Hocus-Pocus/Speeduino-DP1600i-/README.md

# Speeduino-DP1600i-
This is an expanded version of Buggly SPD. It offers the user some options and a proto area if more features than the Buggly SPD board has are desired

WORK IN PROGRESS
