Hocus-Pocus/Speeduino-DP1600i-/KiCad Files/Single VR Conditioner/report.txt

Plot: "C:\Users\angel\Dropbox\My PC (Backup-PC)\Documents\KiCad Projects\Single VR Conditioner\Single VR Conditioner.pdf" OK.

Plot: "C:\Users\angel\Dropbox\My PC (Backup-PC)\Documents\KiCad Projects\Single VR Conditioner\Single VR Conditioner.pdf" OK.
