Hocus-Pocus/Speeduino-DP1600i-/KiCad Files/DP1600iAuxBot/DP1600iAuxBot BOM.xls

DP1600iAuxBot BOM
Designator | Qty | Value | Digikey part
C1 | 1 | 0.01uf | 399-4148-ND (10000pf)
C2 | 1 | 0.1uf | 399-9775-ND
D1,3 | 2 | 1N5818-TP | 1N5818-TCPT-ND
D2,4 | 2 | 1N5231B | 1N5231B-ND
IC1 | 2 | 1x4pin socket | 929850-01-04-ND
J1 | 1 | DB25 board female | 626-2071-ND
J2 | 1 | 1x2 pin socket | 952-1775-ND
J3 | 1 | 1x3 pin socket | A32904-ND
J4 | 1 | 1x6 pin socket | A32907-ND
J5 | 1 | 1x9 pin socket (10) | A26421-ND
J6 | 1 | 1x10 pin socket | A26421-ND
JP1,2 | 2 | 1x2 pin header | 3M9457-36-ND (36 pin)
JP3,4,5,6,7 | 2 | 1x3 pin header
Q1 | 1 | 2N3906-AP | 2N3906-APCT-ND
R1 | 1 | 24K 1/4W 5% | 24KQBK-ND
R2 | 1 | 4.7K 1/4W 5% | 4.7KQBK-ND
R3,14,15 | 3 | 1K 1/4W 5% | 1.0KQBK-ND
