Hocus-Pocus/Speeduino-DP1600i-/KiCad Files/DP1600i/DP1600i BOM.xls

DP1600i BOM
Designator | Qty | Value | Digikey Part
C1,2,5,6,11,13,19,23,26,27,28,29,30 | 13 | 0.1uf | 399-9774-ND
C7,8,14,15,16,24, | 6 | 0.22uf | 399-4288-ND
C9,10 | 2 | 47pf | 399-9737-ND
C17,25 | 2 | 0.01uf | 399-4148-ND (1000pf)
C18 | 1 | 10uf | 399-18278-1-ND
C22 | 1 | 47uf | P19658CT-ND
D1,3,5,7,9,11,13,15,17, | 9 | 1N5818-TP | 1N5818-TPCT-ND
D2,4,6,8,10,12,16,18 | 8 | 1N5321B | 1N5321B-ND
F1 | 1 | MF-R0-50 | MF-R050-ND
J1 | 1 | D25 Board Male | 732-618025231221-ND
J3 | 1 | 1x7 pin header | 609-6393-ND (36 terminals)
J4,J9 | 0 | 1x8 pin header | "
J5 | 0 | 1x4 pin header | "
J6 | 0 | 1x2 pin header | "
J11 | 0 | 1x5 pin header | "
JP1 | 0 | 1x2 pin header | "
J7 | 1 | 2x4 pin header | 3M156309-08-ND
R1 | 1 | 1.5K 1/4W 1% | 1.5KADCT-ND
R2 | 1 | 3.9K 1/4W 1% | 3.9KADCT-ND
R3,4,9,10,11,14 | 6 | 470R 1/4W 5% | 470QBK-ND
R5,6 | 2 | 51K 1/4W 5% | 51KQBK-ND
R7,8 | 2 | 2.49K 1/4W 1% | 2.49KXBK-ND
R12 | 1 | 10K 1/4W 5% | 10KQBK-ND
R13 | 1 | 120R | 120QBK-ND
R15,…R24 | 10 | 22R | CF14JT22ROCT-ND
RV1 | 1 | ERZ-V14P220 | P7307-ND
U1,2 | 2 | MPXH6115 | MPXH6115AC6U
U1,U2 sockets | 2 | 1x4 header sockets | 929850-01-04-ND
U1,U2 pins | 2 | 1x4 90 degree pins | 23-0022122041-ND
U3 | 1 | LM2937ET-5.0 | LM2937ET-5.0-ND
U4,5,6,7,8 | 5 | IXDNI604PI | CLA335-ND
U4,5,6,7,8 sockets | 5 | DIP8 | 110-87-308-41-001101
U10 | 2 | A4988 StepStick sockets | 929850-01-08-10
U9 | 1 | 1ULN2004AN | 296-1980-5-ND
U9 socket | 1 | 110-13-316-41-00100 | ED56163-ND
 | 1 | Hammond 1455N1202 | HM975-ND
