Hocus-Pocus/Speeduino-DP1600i-/KiCad Files/DP1600iAuxTop/DP1600iAuxTop BOM.xls

DP1600iAuxTop BOM
Designator | Qty | Value | Digikey part
D8,,,,D13,D21,…D29,34 | 16 | 1N4001GP-E3/54 | 1N4001GP-E3/54GICT-ND
LED1 | 1 | Orange LED | 1516-1361-ND
LED16,17,18,19 | 4 | Red LED | 1516-1360-ND
LED14,15 | 2 | Yellow LED | 1516-1362-ND
LED30,31,32,33 | 4 | Blue LED | 1516-1365-ND
LED20 | 1 | Yellow/Green LED | 1516-1363-ND
LED2 | 1 | Green LED | 1516-1364-ND
F1,3,…F9 | 6 | Fuse holder | F065-ND
F2 | 1 | RXEF135-1 | RXEF135-1-ND
J1 | 1 | 1x10 pin header | 3M9457-36-ND (36 pin)
J5 | 0 | 1x2 pin header | "
J13 | 0 | 1x6 pin header | "
J20 | 0 | 1x3 pin header | "
J23 | 0 | 1X9 pin header | "
J30 | 1 | 1x2 screw terminal
J31 | 1 | 1x8 screw terminal | (1729076) 277-1242-ND
J32,36 | 2 | 1x3 screw terminal | (1729021) 277-1237-ND
J32,36 | 2 | 1x4 screw terminal | (1729034) 277-1238-ND
J33,35 | 2 | 1x2 screw terminal | (1729018)
J34 | 1 | 1x6 screw terminal | (1729050)
 | 1 | DB25 free male | (DB25-SD-SL) 2057-DB25-D-SL-ND
 | 1 | DB25 free female | (DB25-PD) 2057-DB25-PD-ND
 | 2 | DB25 shell | 116-40-9725H-ND
K1,2 | 2 | 1432786-1 | PB681-ND
K1,2 socket | 2 | Relay socket | VCF4-1000
Q1,2,3,4,5,6 | 6 | AUIRF3205 | AUIRF3205-ND
Q7,8,9,10 | 4 | ISL9V3040P3 | ISL9V3040P3-ND
 | 10 | TO220 insulator | HS417-ND
R7,…R13,R19,…R22 | 13 | 2.4K 1/4W 5% | 2.4KQBK-ND
