Hocus-Pocus/Speeduino-DP1600i-/KiCad Files/VR Conditioner/BOM-octopart-20210223_vr_conditioner_max9926_reg.csv

Qty | Line Item | Manufacturer | MPN | Octopart URL | Schematic Reference | Internal Part Number | Description | Lifecycle Status | Lead Time | RoHS | Total Qty (@ Batch Size: 1) | SKU | SKU | SKU | SKU | Packaging | Packaging | Packaging | Packaging | Unit Price (@ Batch Size: 1) | Unit Price (@ Batch Size: 1) | Unit Price (@ Batch Size: 1) | Unit Price (@ Batch Size: 1) | In Stock | In Stock | In Stock | In Stock | MOQ | MOQ | MOQ | MOQ | URL | URL | URL | URL | Distributor [Lowest Price (Overall)] | SKU [Lowest Price (Overall)] | Packaging [Lowest Price (Overall)] | Unit Price (@ Batch Size: 1) [Lowest Price (Overall)] | Line Total [Lowest Price (Overall)] | Batch Total [Lowest Price (Overall)] | In Stock [Lowest Price (Overall)] | MOQ [Lowest Price (Overall)] | URL [Lowest Price (Overall)] | Notes
 |  |  |  |  |  |  |  |  |  |  |  | Digi-Key | Future Electronics | Mouser | RS Components | Digi-Key | Future Electronics | Mouser | RS Components | Digi-Key | Future Electronics | Mouser | RS Components | Digi-Key | Future Electronics | Mouser | RS Components | Digi-Key | Future Electronics | Mouser | RS Components | Digi-Key | Future Electronics | Mouser | RS Components
1 | GRM1857U1A103JA44D | Murata | GRM1857U1A103JA44D | https://octopart.com/grm1857u1a103ja44d-murata-17754272 |  |  |  | Production (Last Updated: 2 weeks ago) | 23w | Compliant | 1 | 490-8269-1-ND | 1117428 | 81-GRM1857U1A103JA4D |  | Cut Tape | Cut Tape | Tape & Reel |  | 0.15622662 | 0.159777225 | 0.17753025 |  | 24842 | 8000 | 6230 |  | 1 | 1 | 1 |  | https://octopart.com/click/track?country=JE&ct=offers&ppid=17754272&sid=459&sig=0a4da8a&vpid=88253296&ai4=706 | https://octopart.com/click/track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 | https://octopart.com/click/track?country=JE&ct=offers&ppid=17754272&sid=2401&sig=0942290&vpid=37708184&ai4=706 |  | Arrow Electronics | GRM1857U1A103JA44D | Cut Tape | 0.1077253557 | 0.1077253557 | 0.1077253557 | 1 | 1 | https://octopart.com/click/track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
2 | CRCW06031K00FKEAHP | Vishay | CRCW06031K00FKEAHP | https://octopart.com/crcw06031k00fkeahp-vishay-42634138 |  |  |  |  | 24w | Compliant | 2 | 541-1.00KSCT-ND | 7110920 | 71-CRCW06031K00FKEAH | 8206776 | Cut Tape | Cut Tape | Tape & Reel |  | 0.12072057000000001 | 0.104387787 | 0.12072057000000001 |  | 205723 | 16210 | 69615 | 2125 | 1 | 1 | 1 | 25 | https://octopart.com/click/track?country=JE&ct=offers&ppid=42634138&sid=459&sig=04dce86&vpid=115677389&ai4=706 | https://octopart.com/click/track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 | https://octopart.com/click/track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 | https://octopart.com/click/track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 | Farnell | 1738905 | Cut Tape | 0.0412 | 0.0824 | 0.0824 | 32145 | 1 | https://octopart.com/click/track?country=JE&ct=offers&ppid=42634138&sid=819&sig=05fe86e&vpid=250080956&ai4=706
4 | CRCW060310K0FKEAHP | Vishay | CRCW060310K0FKEAHP | https://octopart.com/crcw060310k0fkeahp-vishay-42634028 |  |  |  |  | 24w | Compliant | 4 | 541-10.0KSCT-ND | 6103726 | 71-CRCW060310K0FKEAH | 8206742 | Cut Tape | Cut Tape | Tape & Reel |  | 0.12072057000000001 | 0.104387787 | 0.12072057000000001 |  | 84206 | 65036 | 112208 | 2550 | 1 | 1 | 1 | 25 | https://octopart.com/click/track?country=JE&ct=offers&ppid=42634028&sid=459&sig=0828559&vpid=115262443&ai4=706 | https://octopart.com/click/track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 | https://octopart.com/click/track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 | https://octopart.com/click/track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 | Newark | 68R2991 | Cut Tape | 0.017753025000000002 | 0.07101210000000001 | 0.07101210000000001 | 10760 | 1 | https://octopart.com/click/track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
1 | MAX9926UAEE+ | Maxim Integrated | MAX9926UAEE+ | https://octopart.com/max9926uaee%2B-maxim+integrated-42513566 |  |  |  | Production (Last Updated: 1 month ago) | 6w | Compliant | 1 | MAX9926UAEE+-ND | 3086399 | 700-MAX9926UAEE | 1901381 | Tube | Tube | Tube |  | 4.86432885 |  | 6.44789868 | 4.98 | 1069 | 100 | 299 | 0 | 1 | 100 | 1 | 1 | https://octopart.com/click/track?country=JE&ct=offers&ppid=42513566&sid=459&sig=0fd0a9b&vpid=115650128&ai4=706 | https://octopart.com/click/track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 | https://octopart.com/click/track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 | https://octopart.com/click/track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 | Newark | 73Y6635 |  | 4.73650707 | 4.73650707 | 4.73650707 | 10 | 1 | https://octopart.com/click/track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
1 | GCM188R71C105KA64D | Murata | GCM188R71C105KA64D | https://octopart.com/gcm188r71c105ka64d-murata-13159598 |  |  |  | Production (Last Updated: 2 weeks ago) | 27w | Compliant | 1 | 490-5241-1-ND | 7025260 | 81-GCM188R71C105K64D | 7900562 | Cut Tape | Cut Tape | Tape & Reel |  | 0.15622662 | 0.152676015 | 0.15622662 |  | 272359 | 2118 | 0 | 11400 | 1 | 1 | 1 | 25 | https://octopart.com/click/track?country=JE&ct=offers&ppid=13159598&sid=459&sig=065a155&vpid=34232850&ai4=706 | https://octopart.com/click/track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 | https://octopart.com/click/track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 | https://octopart.com/click/track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 | Arrow Electronics | GCM188R71C105KA64D | Cut Tape | 0.1297391067 | 0.1297391067 | 0.1297391067 | 52386 | 1 | https://octopart.com/click/track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
1 | GRM21BR61E106MA73L | Murata | GRM21BR61E106MA73L | https://octopart.com/grm21br61e106ma73l-murata-46693545 |  |  |  | Production (Last Updated: 2 weeks ago) | 29w | Compliant | 1 | 490-10748-1-ND | 3104124 | 81-GRM21BR61E106MA3L | 1726799 | Cut Tape | Cut Tape | Tape & Reel |  | 0.17753025 | 0.173979645 | 0.18463146 |  | 169134 | 22568 | 63443 | 700 | 1 | 1 | 1 | 50 | https://octopart.com/click/track?country=JE&ct=offers&ppid=46693545&sid=459&sig=0e7381d&vpid=210890997&ai4=706 | https://octopart.com/click/track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 | https://octopart.com/click/track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 | https://octopart.com/click/track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 | Arrow Electronics | GRM21BR61E106MA73L | Cut Tape | 0.1290289857 | 0.1290289857 | 0.1290289857 | 18282 | 1 | https://octopart.com/click/track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
2 | GRM1885C1H102JA01D | Murata | GRM1885C1H102JA01D | https://octopart.com/grm1885c1h102ja01d-murata-196169 |  |  |  | Production (Last Updated: 2 weeks ago) | 29w | Compliant | 2 | 490-1451-1-ND | 5104092 | 81-GRM39C102J50 | 7235795 | Cut Tape | Cut Tape | Tape & Reel |  | 0.07101210000000001 | 0.0102257424 | 0.07101210000000001 |  | 0 | 2890 | 845260 | 5800 | 1 | 1 | 1 | 200 | https://octopart.com/click/track?c=1&country=JE&ct=offers&ppid=196169&sid=459&sig=0c67cea&vpid=1086114&ai4=706 | https://octopart.com/click/track?country=JE&ct=offers&ppid=196169&sid=2454&sig=06c4930&vpid=495870445&ai4=706 | https://octopart.com/click/track?country=JE&ct=offers&ppid=196169&sid=2401&sig=0c58fdf&vpid=37712468&ai4=706 | https://octopart.com/click/track?country=JE&ct=offers&ppid=196169&sid=10022&sig=0888f0c&vpid=199072014&ai4=706 | Future Electronics | 5104092 | Cut Tape | 0.0102257424 | 0.0204514848 | 0.0204514848 | 2890 | 1 | https://octopart.com/click/track?country=JE&ct=offers&ppid=196169&sid=2454&sig=06c4930&vpid=495870445&ai4=706
1 | GCJ188R71C104KA01D | Murata | GCJ188R71C104KA01D | https://octopart.com/gcj188r71c104ka01d-murata-21222040 |  |  |  | Production (Last Updated: 2 weeks ago) | 27w | Compliant | 1 | 490-5796-1-ND | 6113232 | 81-GCJ188R71C104KA1D |  | Cut Tape | Cut Tape | Tape & Reel |  | 0.19173267000000002 | 0.188182065 | 0.17042904 |  | 38484 | 1000 | 178383 |  | 1 | 1 | 1 |  | https://octopart.com/click/track?country=JE&ct=offers&ppid=21222040&sid=459&sig=0e464ea&vpid=44469513&ai4=706 | https://octopart.com/click/track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 | https://octopart.com/click/track?country=JE&ct=offers&ppid=21222040&sid=2401&sig=02bb046&vpid=47654983&ai4=706 |  | Mouser | 81-GCJ188R71C104KA1D | Tape & Reel | 0.17042904 | 0.17042904 | 0.17042904 | 178383 | 1 | https://octopart.com/click/track?country=JE&ct=offers&ppid=21222040&sid=2401&sig=02bb046&vpid=47654983&ai4=706
