Hocus-Pocus/Speeduino-DP1600i-/KiCad Files/DP1600iAuxTop/DP1600iAuxTop.pdf

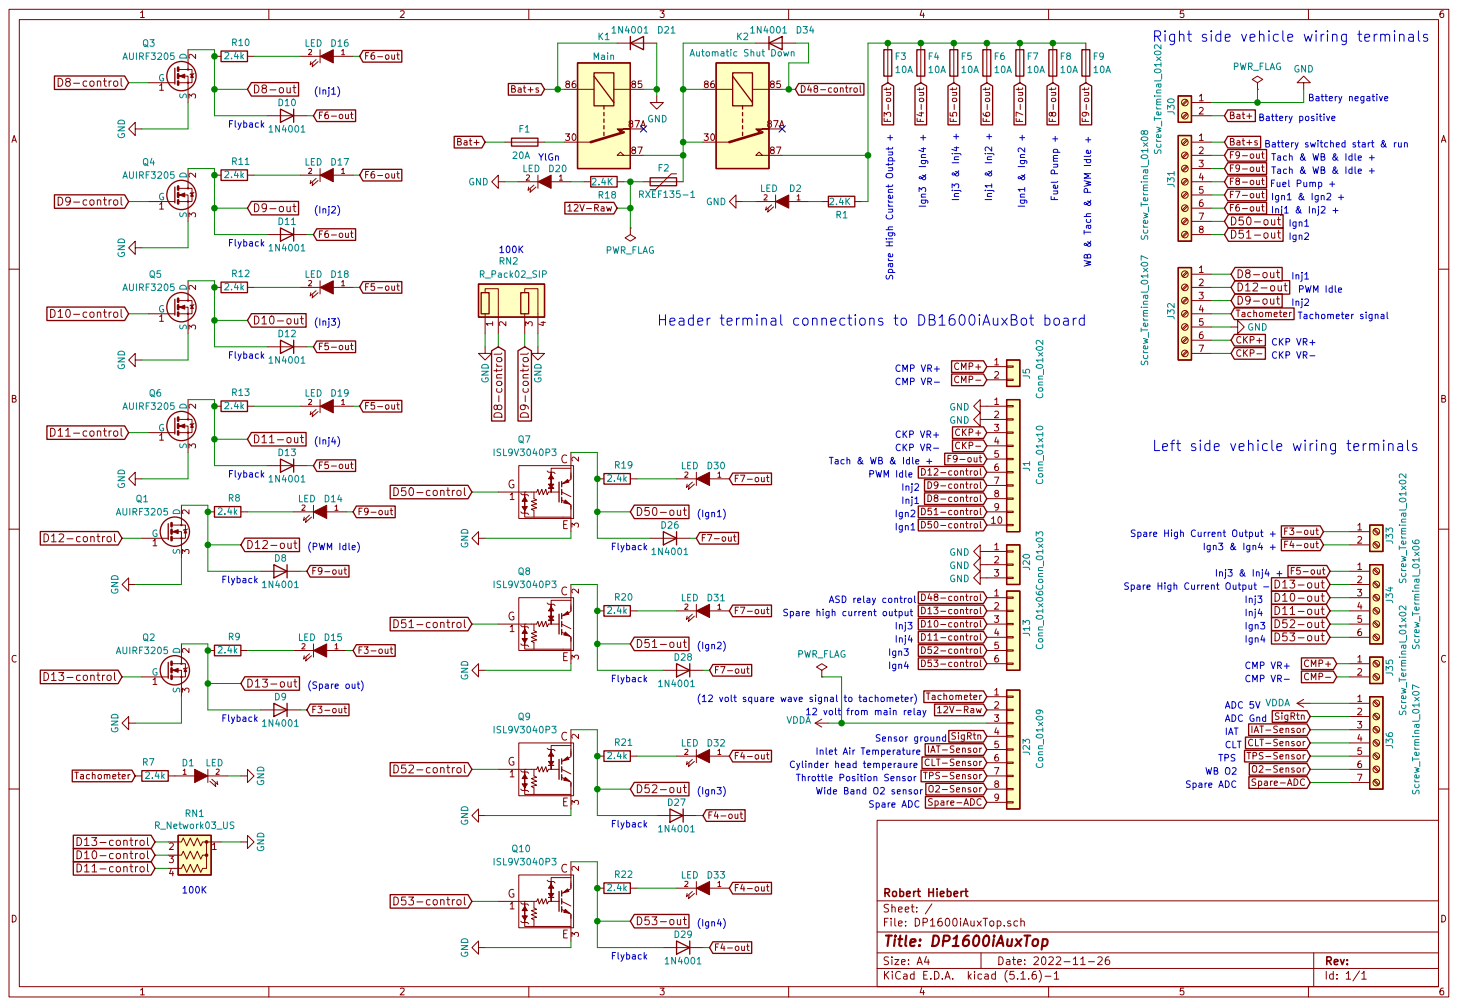
[picture p1: page 1]

Right side vehicle wiring terminals

Battery switched start & run

Header terminal connections to DB1600iAuxBot board

Left side vehicle wiring terminals (Inj4)

Spare-ADC O2-Sensor SigRtnF5-out CLT-Sensor
Inj3 & Inj4 +

Spare High Current Output +

Spare high current output

12 volt from main relay

IAT-Sensor CLT-Sensor O2-Sensor TPS-Sensor Spare-ADC

File: DP1600iAuxTop.sch Sheet: / Robert Hiebert
