Hocus-Pocus/Speeduino-DP1600i-/KiCad Files/DP1600iAuxBot/DP1600iAuxBot.pdf

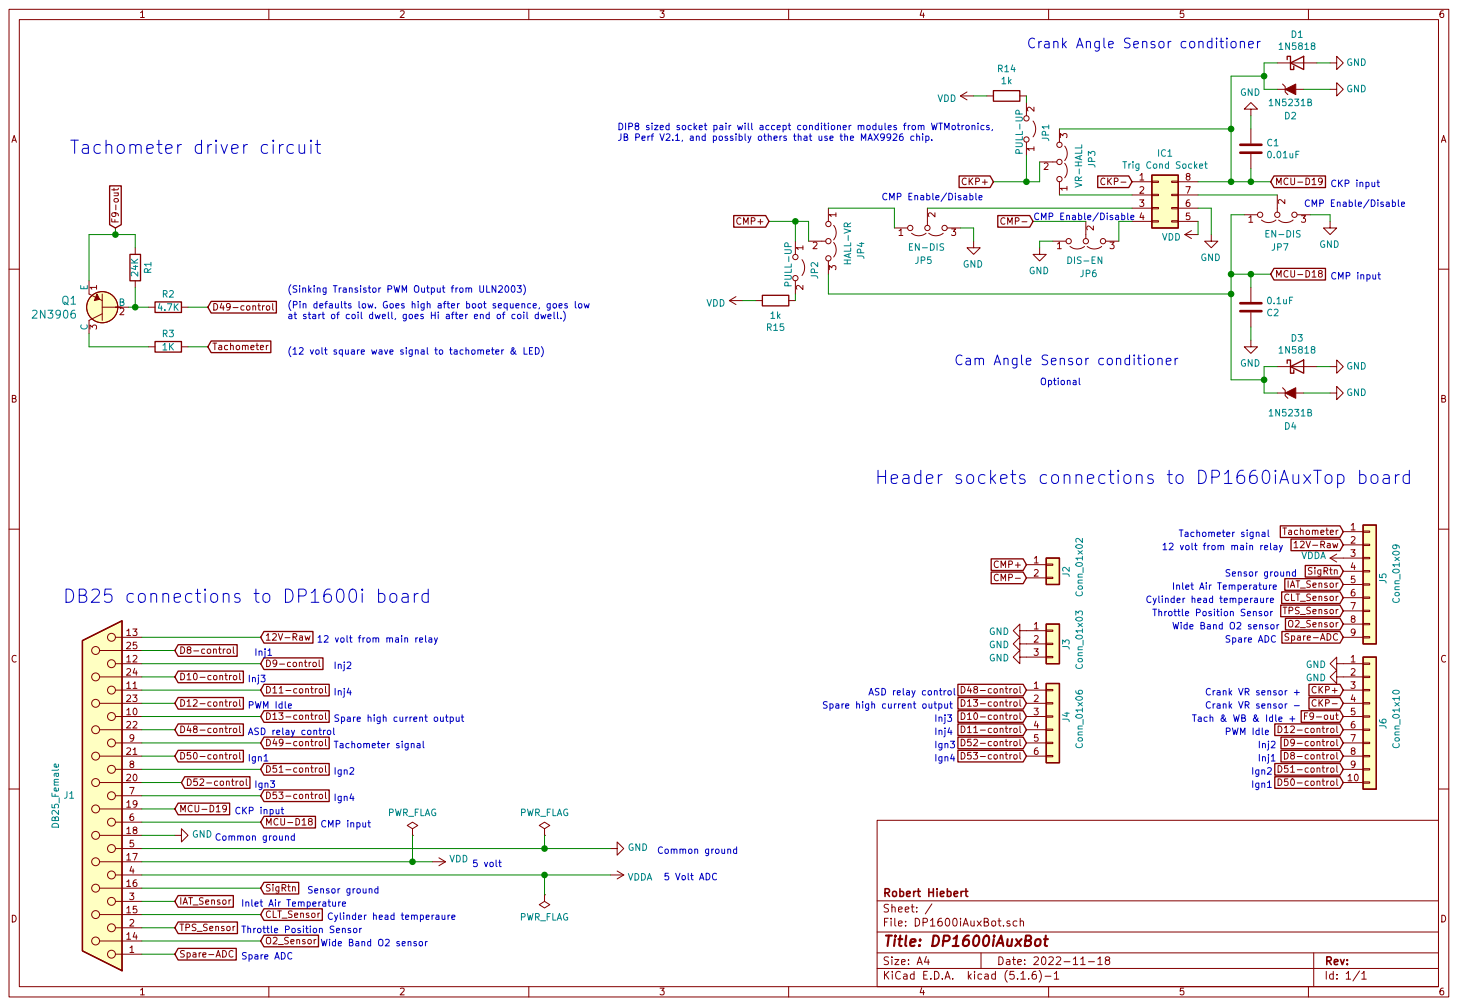
[picture p2: page 1]

Crank Angle Sensor conditioner

DIP8 sized socket pair will accept conditioner modules from WTMotronics,
JB Perf V2.1, and possibly others that use the MAX9926 chip.

(Sinking Transistor PWM Output from ULN2003)
(Pin defaults low. Goes high after boot sequence, goes low

(12 volt square wave signal to tachometer & LED)

Cam Angle Sensor conditioner

Tachometer signal
12 volt from main relay

Id: 1/1 Title: DP1600iAuxBot File: DP1600iAuxBot.sch Sheet: / Robert Hiebert

Inlet Air Temperature
Throttle Position Sensor Wide Band O2 sensor Cylinder head temperaure
