Hocus-Pocus/Speeduino-DP1600i-/KiCad Files/DP1600i/DP1600i.pdf

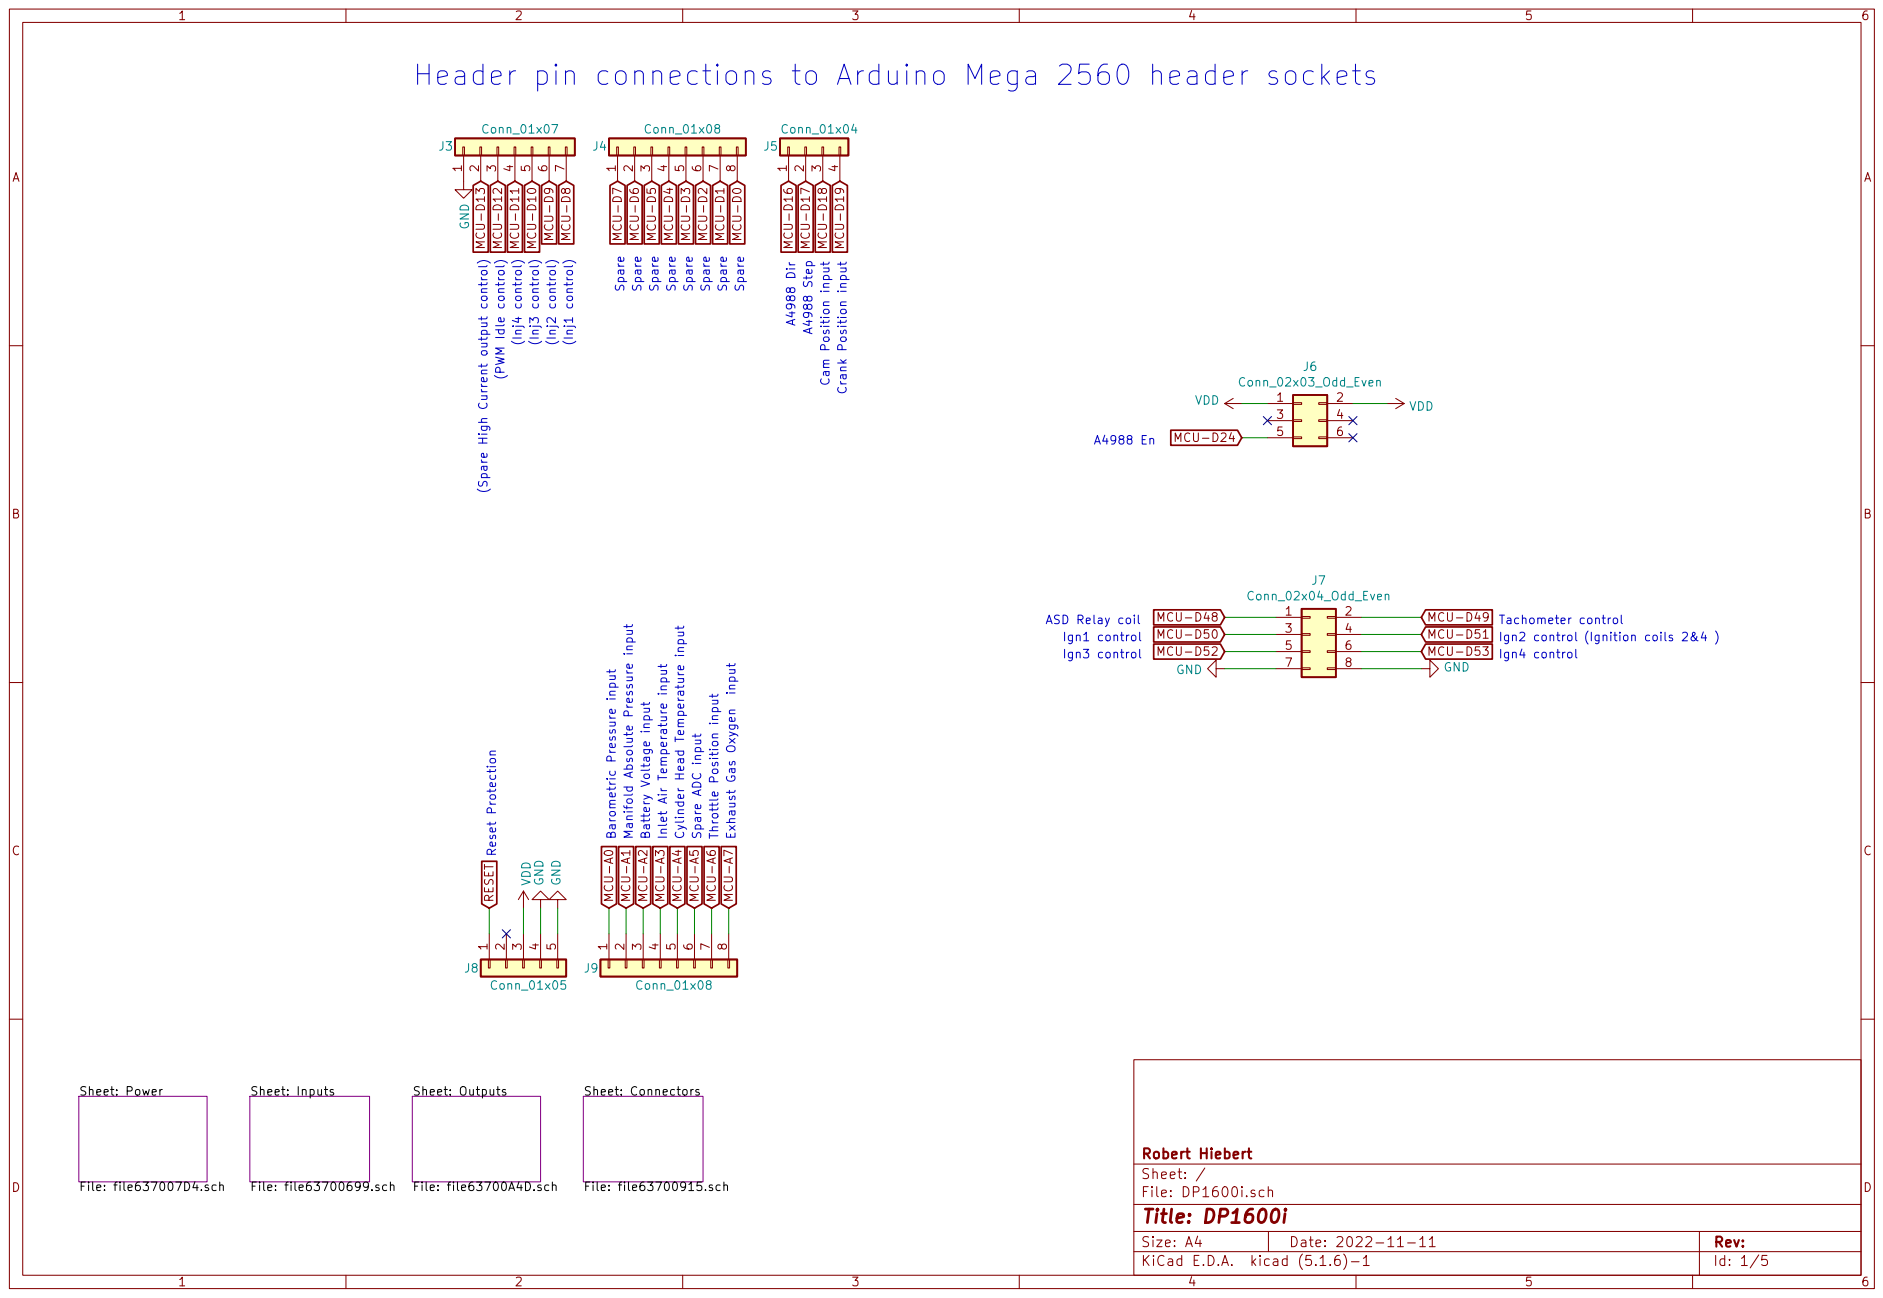
[picture p3: page 1]

VDD VDD GND GND

ASD Relay coil Cam Position input Crank Position input

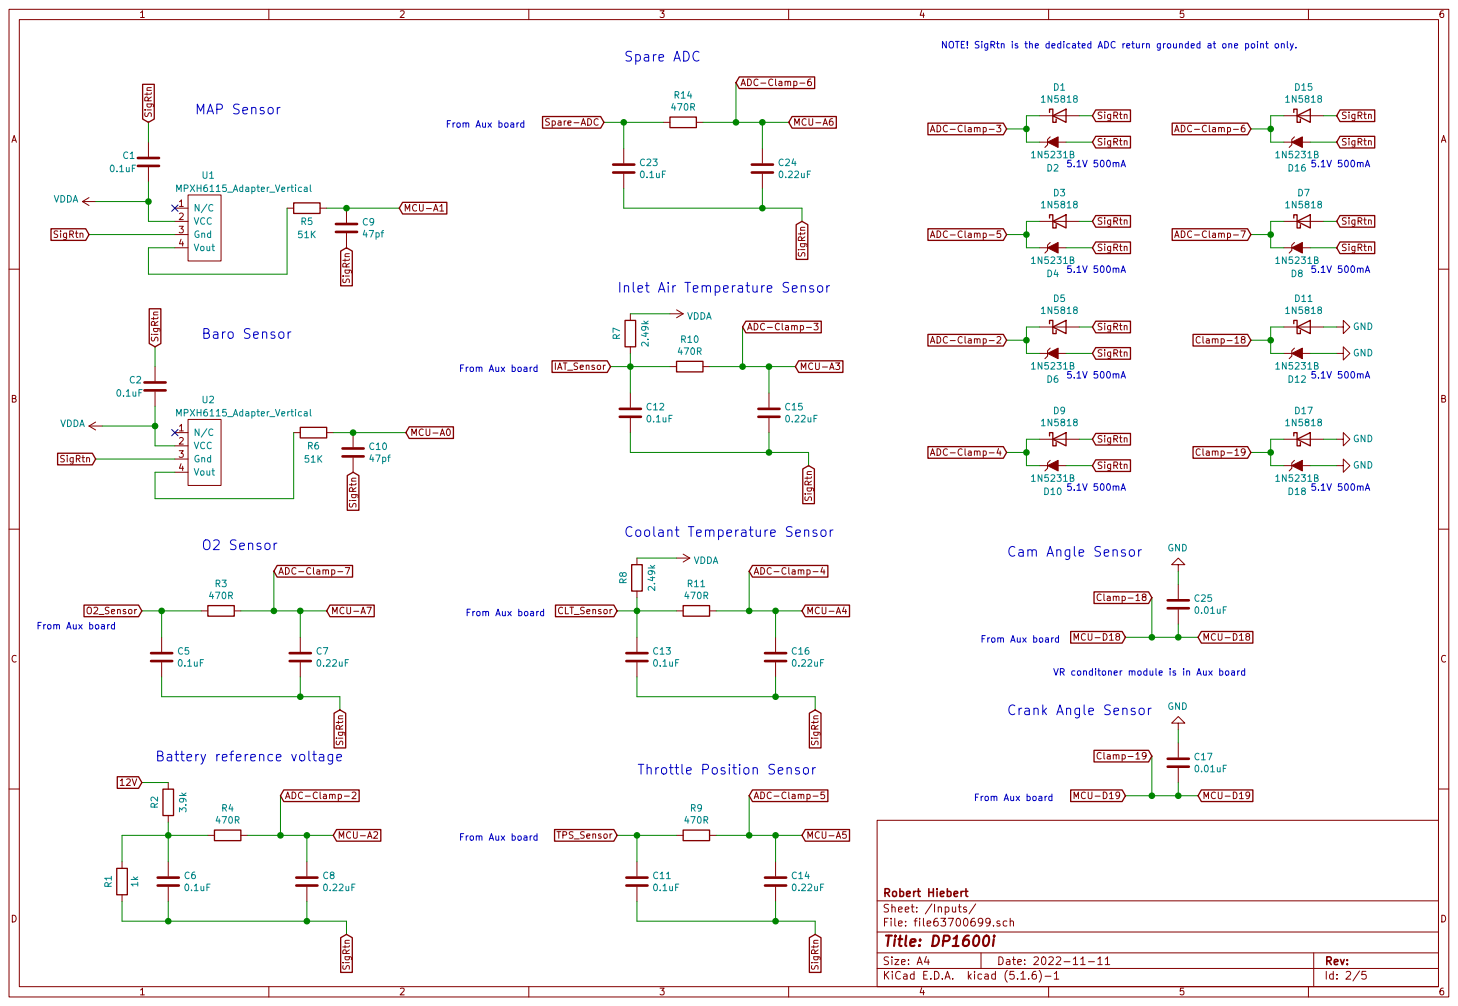
[picture p4: page 2]

From Aux board MAP Sensor

Inlet Air Temperature Sensor

Crank Angle Sensor From Aux board

Id: 2/5 Title: DP1600i File: file63700699.sch Sheet: /Inputs/ Robert Hiebert

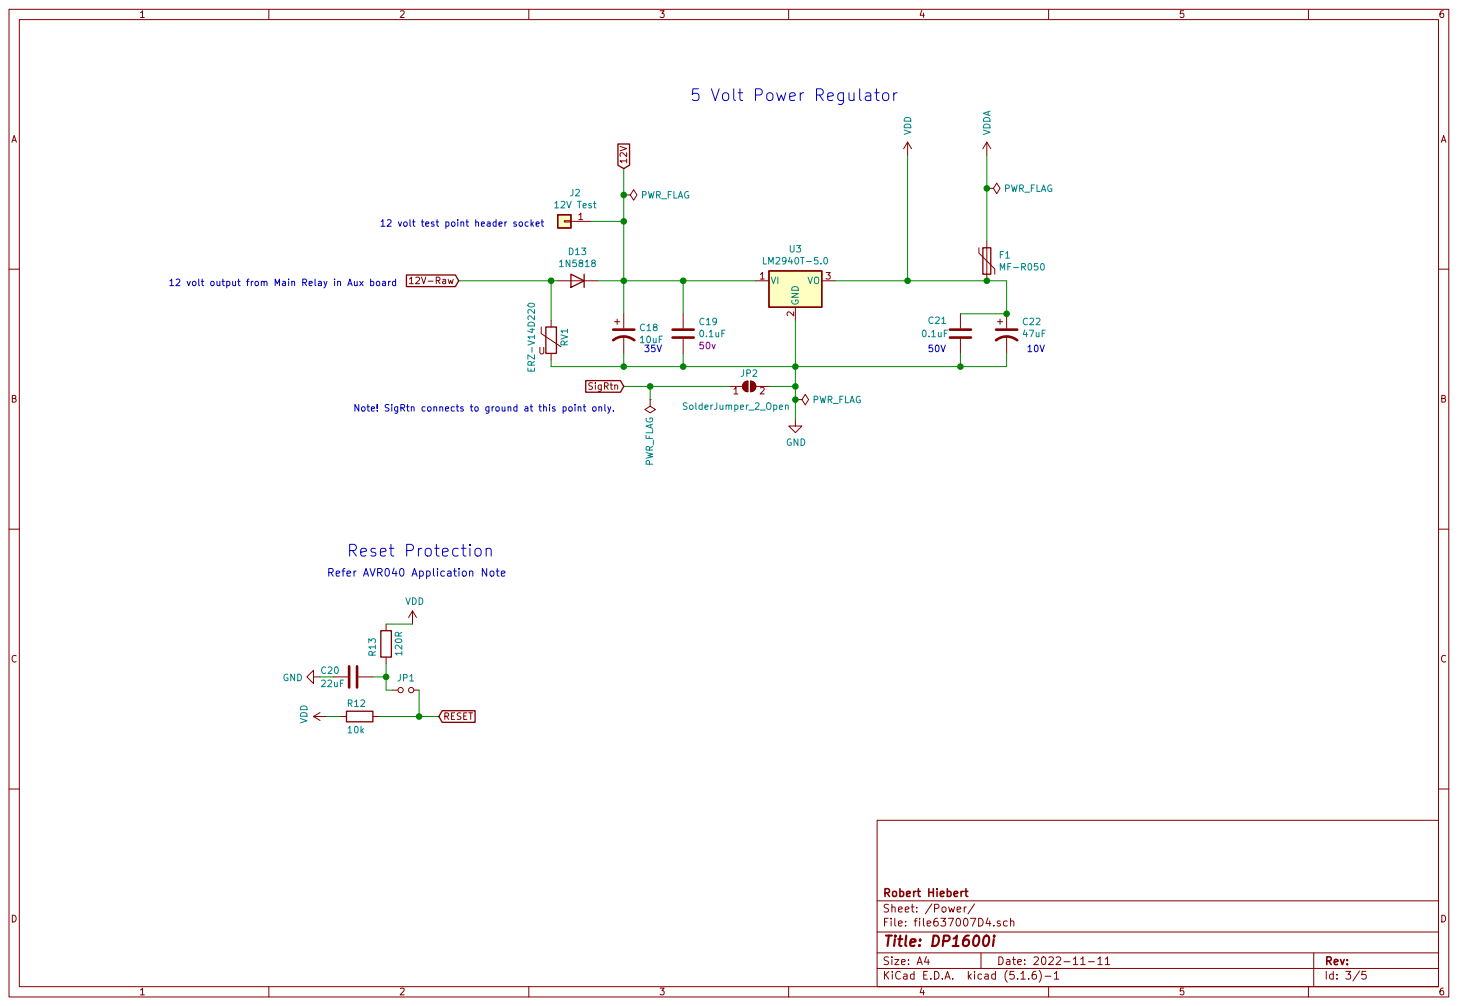
[picture p5: page 3]

Id: 3/5 Title: DP1600i File: file637007D4.sch Sheet: /Power/ Robert Hiebert VDD

12 volt output from Main Relay in Aux board

Note! SigRtn connects to ground at this point only.

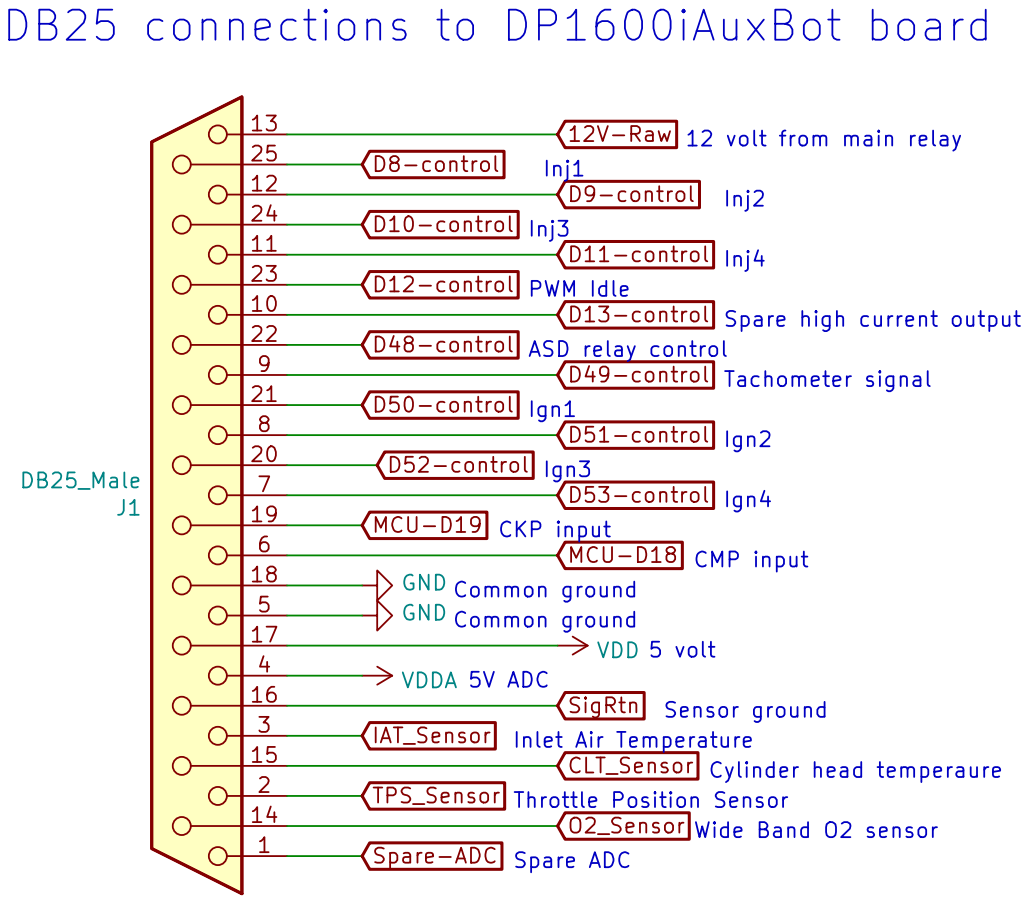
[picture p6: page 4]

5 volt 5V ADC DB25 connections to DP1600iAuxBot board

12 volt from main relay

Spare high current output PWM Idle

Id: 4/5 Title: DP1600i File: file63700915.sch Sheet: /Connectors/ Robert Hiebert VDDA 1

Inlet Air Temperature
CLT_Sensor
Cylinder head temperaure Wide Band O2 sensor Throttle Position Sensor Spare ADC

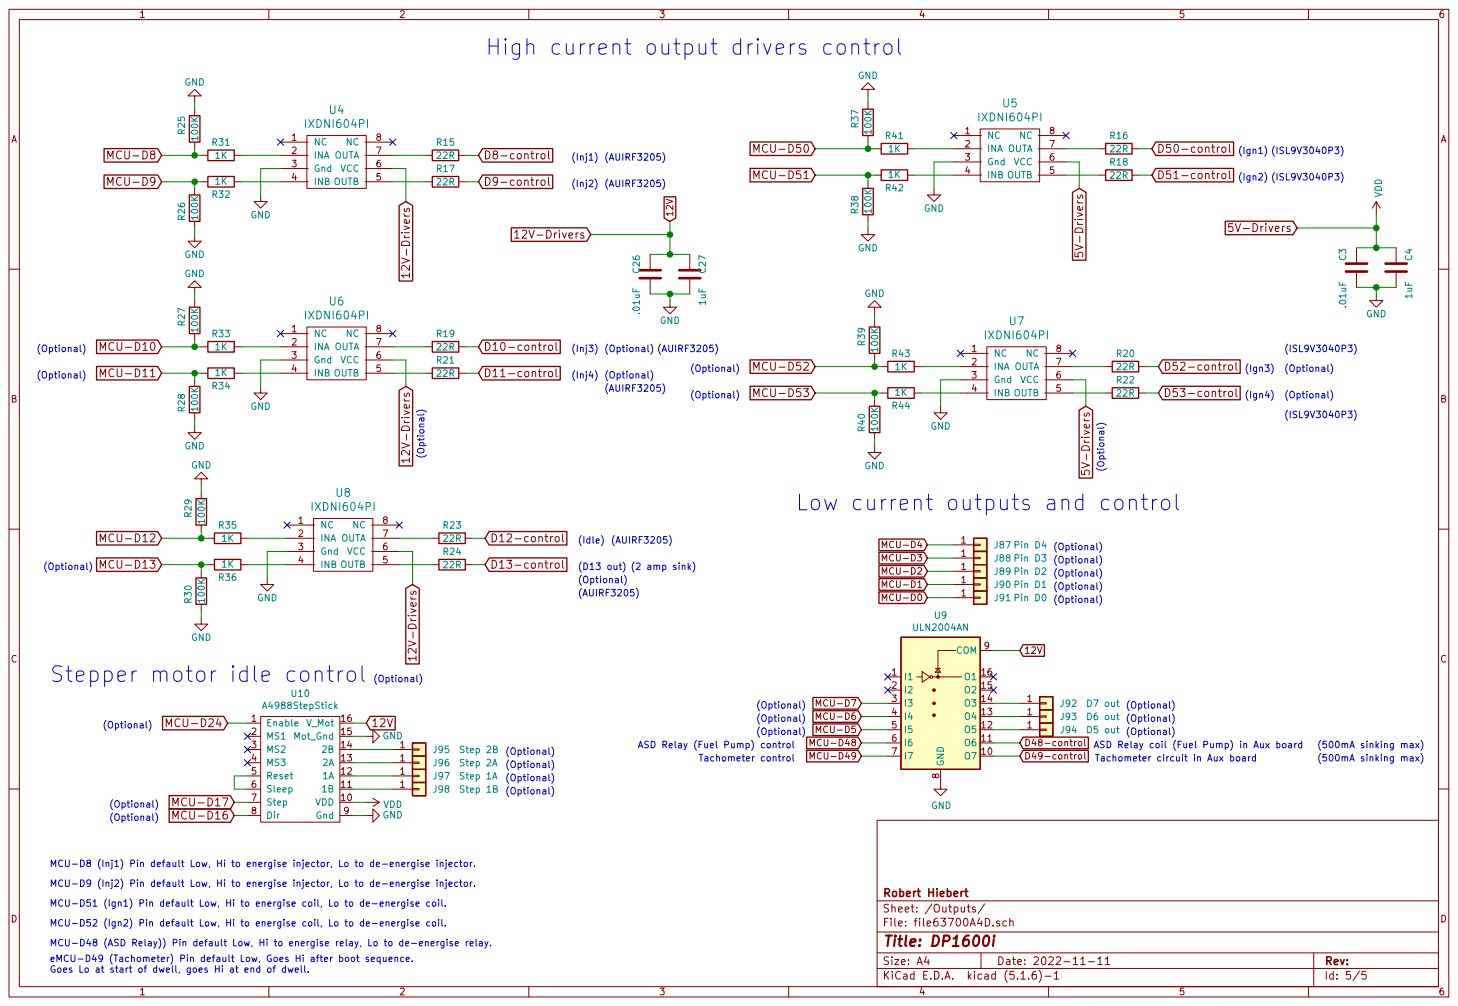
[picture p7: page 5]

High current output drivers control

Low current outputs and control

Stepper motor idle control

MCU-D8 (Inj1) Pin default Low, Hi to energise injector, Lo to de-energise injector.
MCU-D9 (Inj2) Pin default Low, Hi to energise injector, Lo to de-energise injector.
MCU-D51 (Ign1) Pin default Low, Hi to energise coil, Lo to de-energise coil.
MCU-D52 (Ign2) Pin default Low, Hi to energise coil, Lo to de-energise coil.
MCU-D48 (ASD Relay)) Pin default Low, Hi to energise relay, Lo to de-energise relay.
eMCU-D49 (Tachometer) Pin default Low, Goes Hi after boot sequence.
Goes Lo at start of dwell, goes Hi at end of dwell.

Id: 5/5 Title: DP1600i File: file63700A4D.sch Sheet: /Outputs/ Robert Hiebert
