Hocus-Pocus/Speeduino-DP1600i-/KiCad Files/Single VR Conditioner/Single VR Conditioner.pdf

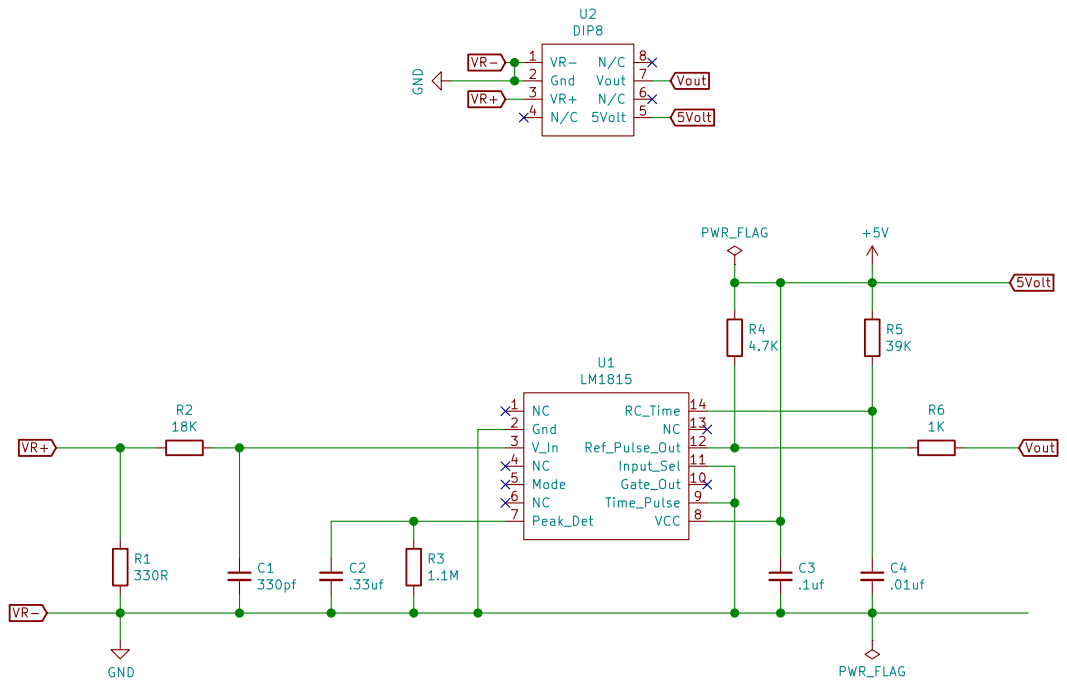
[picture p8: page 1]

File: Single VR Conditioner.sch Sheet: / R. Hiebert Electric C1

Id: 1/1 Title: Buggly Gruesome Single VR Conditioner
