Hocus-Pocus/Speeduino-DP1600i-/KiCad Files/DP1600iAuxBot/DP1600iAuxBot.kicad_pcb

## KiCad design KiCad Files/DP1600iAuxBot/DP1600iAuxBot.kicad_pcb (2022-12-12)

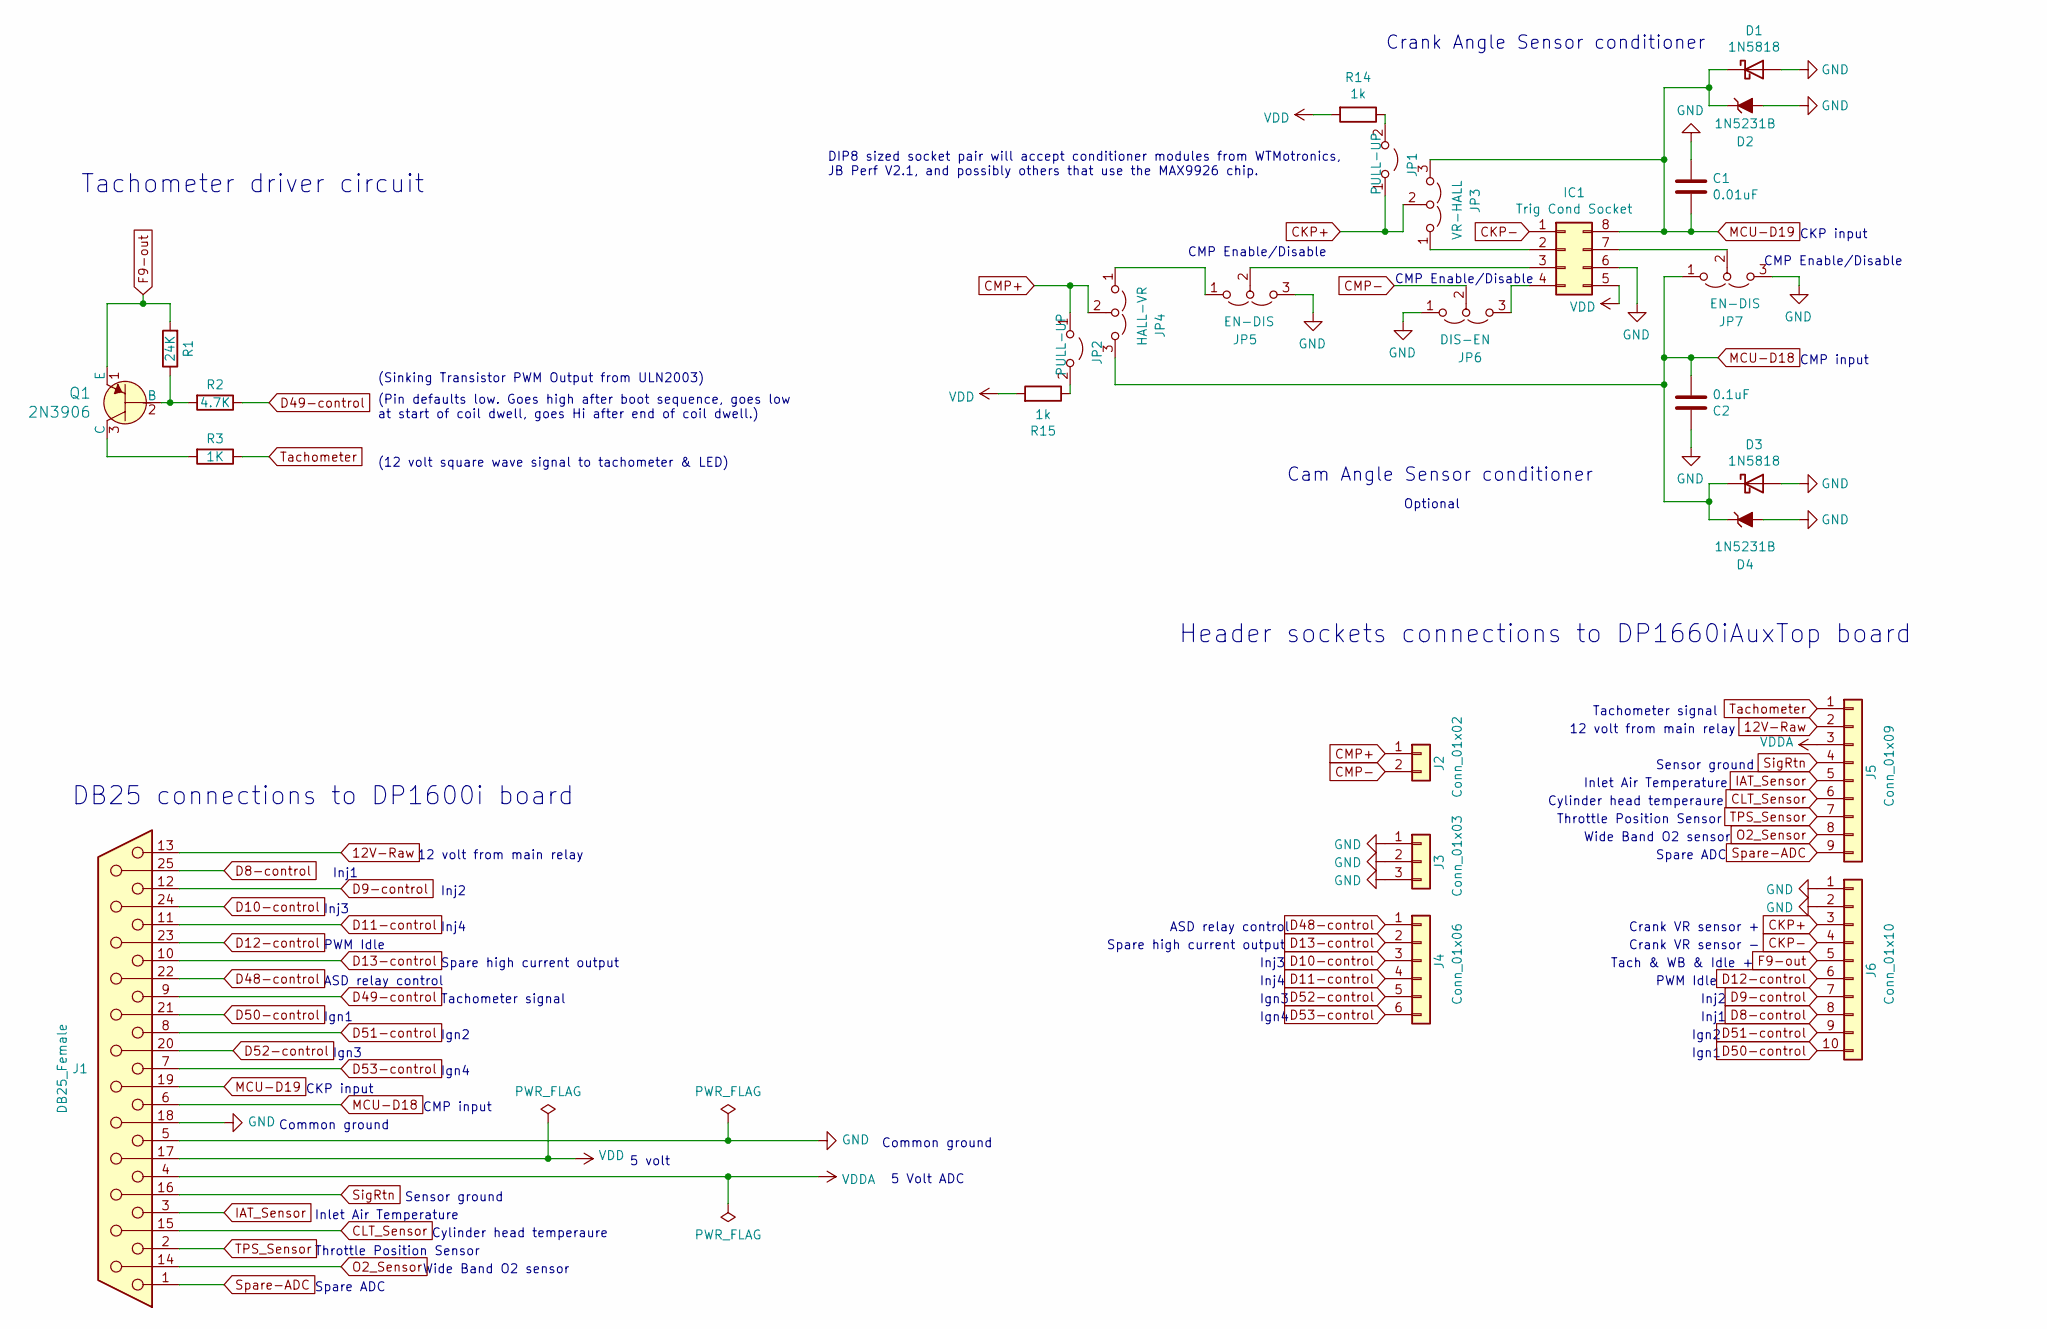
[picture p9: schematic DP1600iAuxBot.sch]

Parts:
C1: 0.01uF; C_Disc_D5.0mm_W2.5mm_P2.50mm; Manufacturer_Part_Number FA18X7R1H103KNU06; Digikey Part Number 445-174244-1-ND
C2: 0.1uF; C_Disc_D5.0mm_W2.5mm_P2.50mm; Manufacturer_Part_Number FA18X8R1E104KNU06; Digikey Part Number 445-180563-1-ND
D1, D3: 1N5818; D_DO-41_SOD81_P10.16mm_Horizontal
D2, D4: 1N5231B; D_DO-41_SOD81_P10.16mm_Horizontal
IC1: Trig Cond Socket; DIP-8_W7.62mm_Socket
J1: DB25_Female; DSUB-25_Female_Horizontal_P2.77x2.84mm_EdgePinOffset4.94mm_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
J2: Conn_01x02; PinHeader_1x02_P2.54mm_Vertical
J3: Conn_01x03; PinHeader_1x03_P2.54mm_Vertical
J4: Conn_01x06; PinHeader_1x06_P2.54mm_Vertical
J5: Conn_01x09; PinHeader_1x09_P2.54mm_Vertical
J6: Conn_01x10; PinHeader_1x10_P2.54mm_Vertical
JP1, JP2: PULL-UP; PinHeader_1x02_P2.54mm_Vertical; Manufacturer_Part_Number M20-9990245; Digikey Part Number 952-2261-ND
JP3: VR-HALL; PinHeader_1x03_P2.54mm_Vertical; Manufacturer_Part_Number M20-9990345; Digikey Part Number 952-2263-ND
JP4: HALL-VR; PinHeader_1x03_P2.54mm_Vertical; Manufacturer_Part_Number M20-9990345; Digikey Part Number 952-2263-ND
JP5, JP7: EN-DIS; PinHeader_1x03_P2.54mm_Vertical; Manufacturer_Part_Number M20-9990345; Digikey Part Number 952-2263-ND
JP6: DIS-EN; PinHeader_1x03_P2.54mm_Vertical; Manufacturer_Part_Number M20-9990345; Digikey Part Number 952-2263-ND
Q1: 2N3906; TO-92_Inline_Wide; MPN 2N3906; Digi-Key_PN 2N3906CS-ND
R1: 24K; R_Axial_DIN0207_L6.3mm_D2.5mm_P7.62mm_Horizontal
R2: 4.7K; R_Axial_DIN0207_L6.3mm_D2.5mm_P7.62mm_Horizontal
R3: 1K; R_Axial_DIN0207_L6.3mm_D2.5mm_P7.62mm_Horizontal
R14, R15: 1k; R_Axial_DIN0207_L6.3mm_D2.5mm_P7.62mm_Horizontal; Manufacturer_Part_Number MBA02040C1001FRP00; Digikey Part Number BC1.00KXCT-ND

Connections:
12V-Raw: J1.13, J5.2
CKP+: J6.3, JP1.1 (A), JP3.2 (C)
CKP-: IC1.1, J6.4
CLT_Sensor: J1.15, J5.6
CMP+: J2.1, JP2.1 (A), JP4.2 (C)
CMP-: J2.2, JP6.2 (C)
D8-control: J1.25, J6.8
D9-control: J1.12, J6.7
D10-control: J1.24, J4.3
D11-control: J1.11, J4.4
D12-control: J1.23, J6.6
D13-control: J1.10, J4.2
D48-control: J1.22, J4.1
D49-control: J1.9, R2.1
D50-control: J1.21, J6.10
D51-control: J1.8, J6.9
D52-control: J1.20, J4.5
D53-control: J1.7, J4.6
F9-out: J6.5, Q1.1 (E), R1.2
GND: C1.1, C2.1, D1.2 (A), D2.2 (A), D3.2 (A), D4.2 (A), IC1.6, J1.5, J1.18, J3.1, J3.2, J3.3, J6.1, J6.2, JP5.3 (B), JP6.1 (A), JP7.3 (B)
IAT_Sensor: J1.3, J5.5
MCU-D18: C2.2, D3.1 (K), D4.1 (K), J1.6, JP4.3 (B), JP7.1 (A)
MCU-D19: C1.2, D1.1 (K), D2.1 (K), IC1.8, J1.19, JP3.3 (B)
unnamed: IC1.2, JP3.1 (A)
unnamed: IC1.3, JP5.2 (C)
unnamed: IC1.4, JP6.3 (B)
unnamed: IC1.7, JP7.2 (C)
unnamed: JP1.2 (B), R14.1
unnamed: JP2.2 (B), R15.1
unnamed: JP4.1 (A), JP5.1 (A)
unnamed: Q1.2 (B), R1.1, R2.2
unnamed: Q1.3 (C), R3.2
O2_Sensor: J1.14, J5.8
SigRtn: J1.16, J5.4
Spare-ADC: J1.1, J5.9
TPS_Sensor: J1.2, J5.7
Tachometer: J5.1, R3.1
VDD: IC1.5, J1.17, R14.2, R15.2
VDDA: J1.4, J5.3

Notes on the sheet:
Crank Angle Sensor conditioner
Cam Angle Sensor conditioner
(Sinking Transistor PWM Output from ULN2003)
(12 volt square wave signal to tachometer & LED)
DB25 connections to DP1600i board
Crank VR sensor +
Crank VR sensor -
12 volt from main relay
Inj1
Inj2
Inj3
Inj4
PWM Idle
Spare high current output
ASD relay control
Tachometer signal
Ign1
Ign2
Ign3
Ign4
CKP input
CMP input
Common ground
5 volt
Sensor ground
Spare ADC
Throttle Position Sensor
Wide Band O2 sensor
Cylinder head temperaure
Inlet Air Temperature
5 Volt ADC
Tach & WB & Idle +
Tachometer driver circuit
Header sockets connections to DP1660iAuxTop board
DIP8 sized socket pair will accept conditioner modules from WTMotronics, JB Perf V2.1, and possibly others that use the MAX9926 chip.
(Pin defaults low. Goes high after boot sequence, goes low at start of coil dwell, goes Hi after end of coil dwell.)
CMP Enable/Disable
Optional

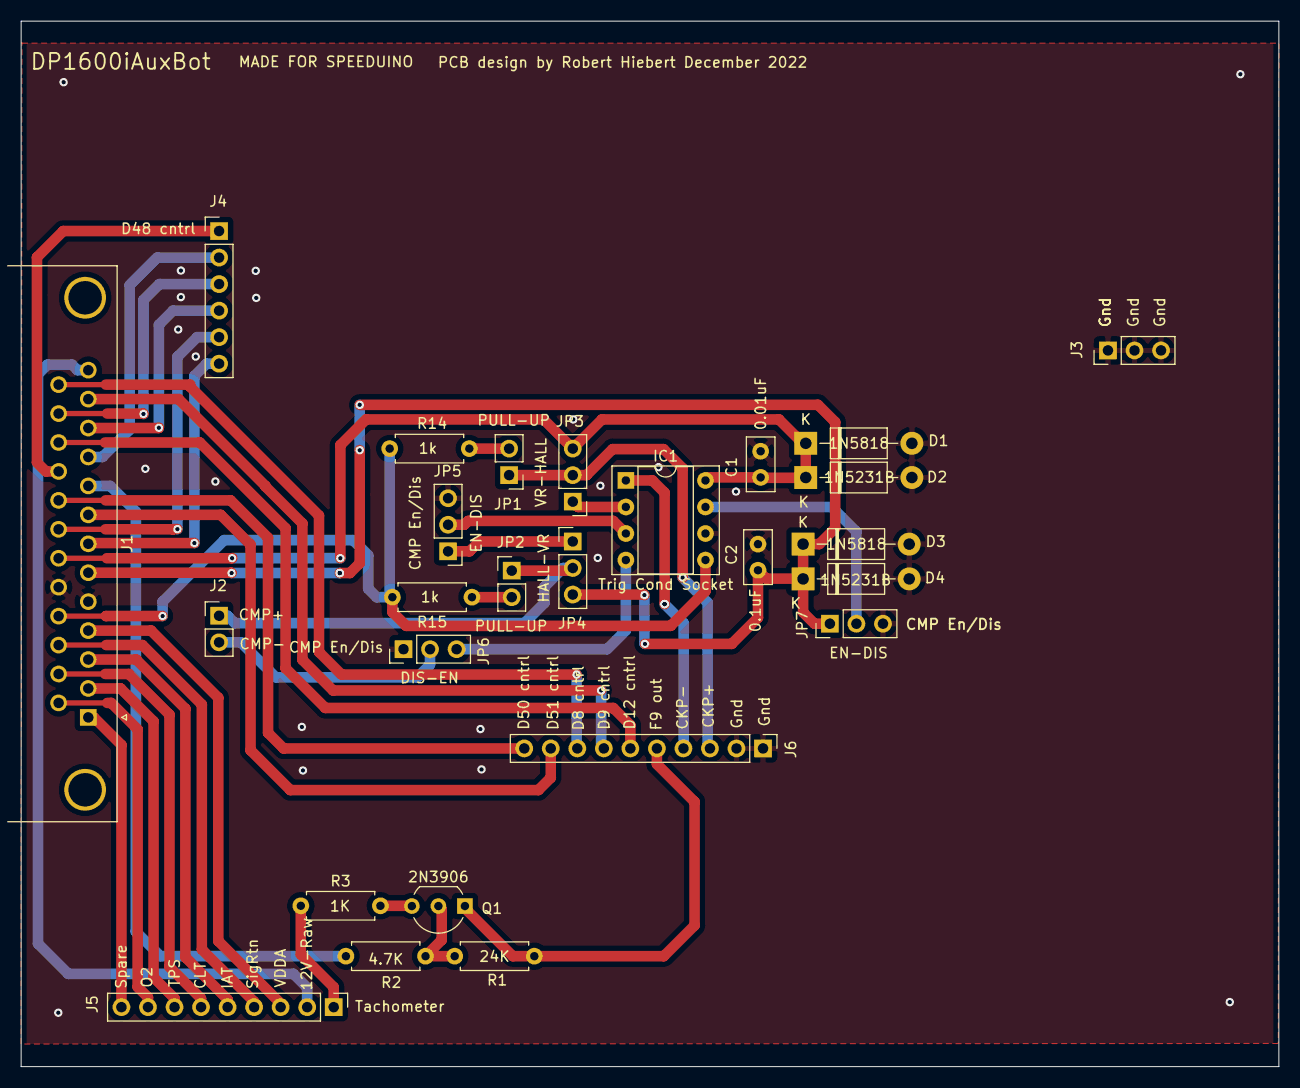
[picture p10: board DP1600iAuxBot.kicad_pcb from above]

Board: 2 copper layers, 120.4 x 100.1 mm, 26 parts (0 on the bottom side), 39 nets.
