Hocus-Pocus/Speeduino-DP1600i-/KiCad Files/DP1600i/DP1600i.kicad_pcb

## KiCad design KiCad Files/DP1600i/DP1600i.kicad_pcb (2022-12-12)

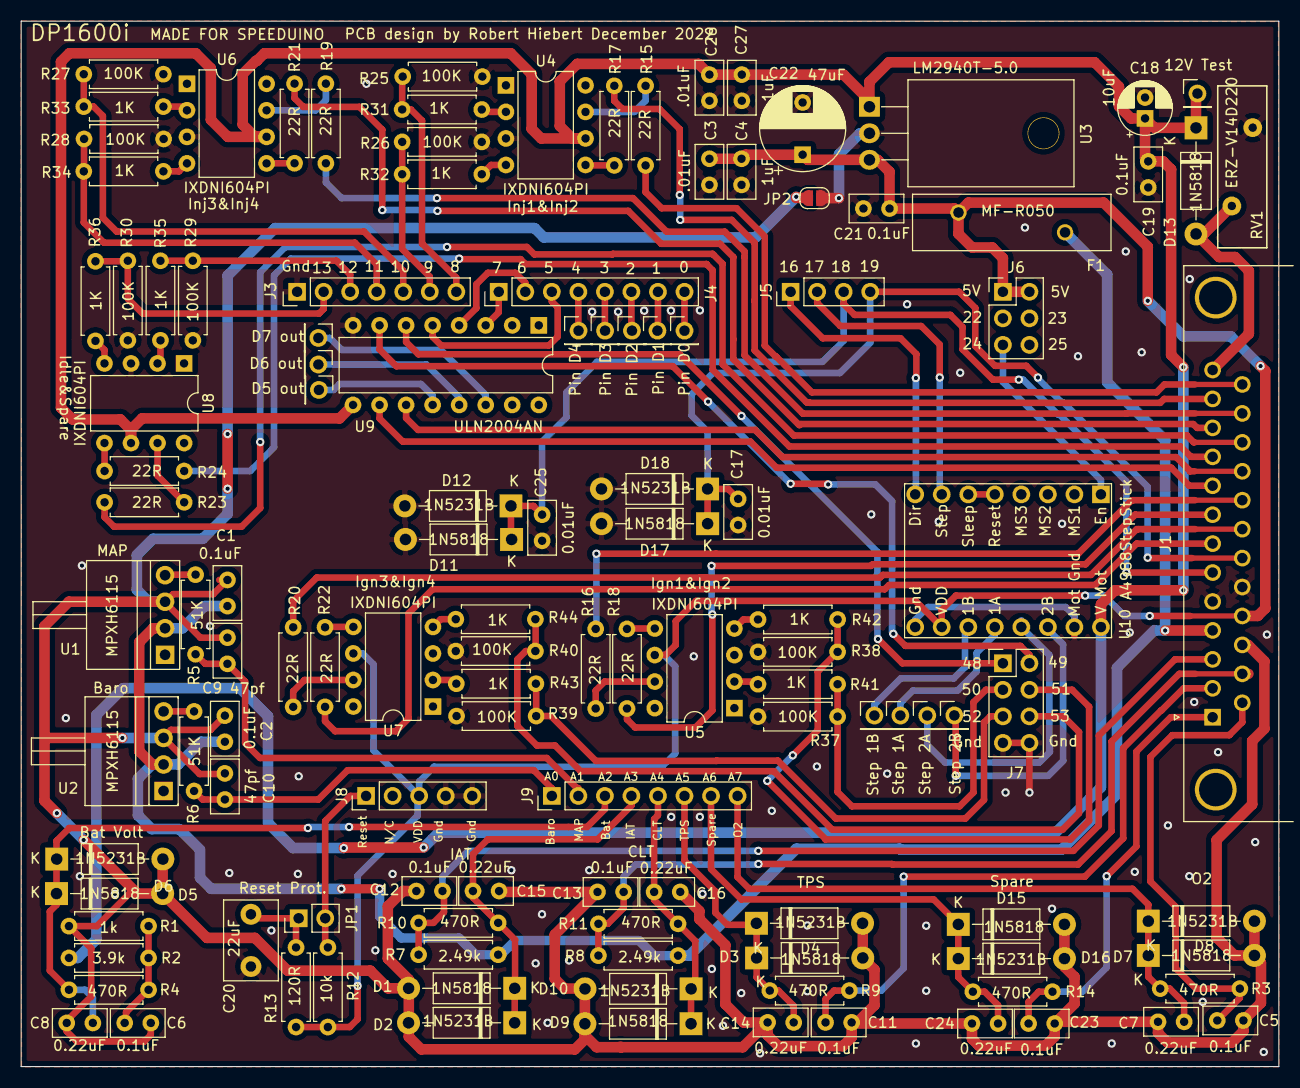
[picture p11: board DP1600i.kicad_pcb from above]

Board: 2 copper layers, 120.4 x 100.1 mm, 123 parts (0 on the bottom side), 89 nets.

Parts:
C1, C2, C5, C6, C11, C12, C13, C19, C21, C23: 0.1uF; C_Disc_D5.0mm_W2.5mm_P2.50mm
C3, C26: .01uF; C_Disc_D5.0mm_W2.5mm_P2.50mm
C4, C27: 1uF; C_Disc_D5.0mm_W2.5mm_P2.50mm
C7, C8, C14, C15, C16, C24: 0.22uF; C_Disc_D5.0mm_W2.5mm_P2.50mm
C9, C10: 47pf; C_Disc_D5.0mm_W2.5mm_P2.50mm
C17, C25: 0.01uF; C_Disc_D5.0mm_W2.5mm_P2.50mm
C18: 10uF; CP_Radial_D5.0mm_P2.00mm
C20: 22uF; C_Disc_D7.5mm_W5.0mm_P5.00mm
C22: 47uF; CP_Radial_D8.0mm_P5.00mm
D1, D3, D5, D7, D9, D11, D13, D15, D17: 1N5818; D_DO-41_SOD81_P10.16mm_Horizontal
D2, D4, D6, D8, D10, D12, D16, D18: 1N5231B; D_DO-41_SOD81_P10.16mm_Horizontal
F1: MF-R050; Fuse_BelFuse_0ZRE0100FF_L18.7mm_W5.1mm
J1: DB25_Male; DSUB-25_Male_Horizontal_P2.77x2.84mm_EdgePinOffset4.94mm_Ho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
J2: 12V Test; Jumper-Pad
J3: Conn_01x07; PinHeader_1x07_P2.54mm_Vertical
J4, J9: Conn_01x08; PinHeader_1x08_P2.54mm_Vertical
J5: Conn_01x04; PinHeader_1x04_P2.54mm_Vertical
J6: Conn_02x03_Odd_Even; PinHeader_2x03_P2.54mm_Vertical
J7: Conn_02x04_Odd_Even; PinHeader_2x04_P2.54mm_Vertical
J8: Conn_01x05; PinHeader_1x05_P2.54mm_Vertical
J87: Pin D4; Jumper-Pad
J88: Pin D3; Jumper-Pad
J89: Pin D2; Jumper-Pad
J90: Pin D1; Jumper-Pad
J91: Pin D0; Jumper-Pad
J92: D7 out; Jumper-Pad
J93: D6 out; Jumper-Pad
J94: D5 out; Jumper-Pad
J95: Step 2B; Jumper-Pad
J96: Step 2A; Jumper-Pad
J97: Step 1A; Jumper-Pad
J98: Step 1B; Jumper-Pad
JP1: Jumper_NO_Small; PinHeader_1x02_P2.54mm_Vertical
JP2: SolderJumper_2_Open; SolderJumper-2_P1.3mm_Open_RoundedPad1.0x1.5mm
R1: 1k; R_Axial_DIN0207_L6.3mm_D2.5mm_P7.62mm_Horizontal
R2: 3.9k; R_Axial_DIN0207_L6.3mm_D2.5mm_P7.62mm_Horizontal
R3, R4, R9, R10, R11, R14: 470R; R_Axial_DIN0207_L6.3mm_D2.5mm_P7.62mm_Horizontal
R5, R6: 51K; R_Axial_DIN0207_L6.3mm_D2.5mm_P7.62mm_Horizontal
R7, R8: 2.49k; R_Axial_DIN0207_L6.3mm_D2.5mm_P7.62mm_Horizontal
R12: 10k; R_Axial_DIN0207_L6.3mm_D2.5mm_P7.62mm_Horizontal
R13: 120R; R_Axial_DIN0207_L6.3mm_D2.5mm_P7.62mm_Horizontal
R15, R16, R17, R18, R19, R20, R21, R22, R23, R24: 22R; R_Axial_DIN0207_L6.3mm_D2.5mm_P7.62mm_Horizontal
R25, R26, R27, R28, R29, R30, R37, R38, R39, R40: 100K; R_Axial_DIN0207_L6.3mm_D2.5mm_P7.62mm_Horizontal
R31, R32, R33, R34, R35, R36, R41, R42, R43, R44: 1K; R_Axial_DIN0207_L6.3mm_D2.5mm_P7.62mm_Horizontal
RV1: ERZ-V14D220; RV_Disc_D15.5mm_W4.7mm_P7.5mm
U1, U2: MPXH6115_Adapter_Vertical
U3: LM2940T-5.0; TO-220-3_Horizontal_TabDown
U4, U5, U6, U7, U8: IXDNI604PI; DIP-8_W7.62mm
U9: ULN2004AN; DIP-16_W7.62mm
U10: A4988StepStick

Connections:
5V-Drivers: C3.2, C4.2, C21.1, C22.1, F1.2, J1.17, J6.1, J6.2, J8.3, R12.2, R13.2, U3.3, U5.6, U7.6, U10.10
12V: C18.1, C19.1, C26.2, C27.2, D13.1, J2.1, R2.2, U3.1, U4.6, U6.6, U8.6, U9.9, U10.16
12V-Raw: D13.2, J1.13, RV1.1
ADC-Clamp-2: C8.1, D5.1, D6.1, J9.3, R4.1
ADC-Clamp-3: C15.1, D1.1, D2.1, J9.4, R10.1
ADC-Clamp-4: C16.1, D9.1, D10.1, J9.5, R11.1
ADC-Clamp-5: C14.1, D3.1, D4.1, J9.6, R9.1
ADC-Clamp-6: C24.1, D15.1, D16.1, J9.7, R14.1
ADC-Clamp-7: C7.1, D7.1, D8.1, J9.8, R3.1
CLT_Sensor: C13.1, J1.15, R8.1, R11.2
Clamp-18: C25.2, D11.1, D12.1, J1.6, J5.3
Clamp-19: C17.2, D17.1, D18.1, J1.19, J5.4
D8-control: J1.25, R15.1
D9-control: J1.12, R17.1
D10-control: J1.24, R19.1
D11-control: J1.11, R21.1
D12-control: J1.23, R23.1
D13-control: J1.10, R24.1
D48-control: J1.22, U9.11
D49-control: J1.9, U9.10
D50-control: J1.21, R16.1
D51-control: J1.8, R18.1
D52-control: J1.20, R20.1
D53-control: J1.7, R22.1
GND: C3.1, C4.1, C17.1, C18.2, C19.2, C20.2, C21.2, C22.2, C25.1, C26.1, C27.1, D11.2, D12.2, D17.2, D18.2, J1.5, J1.18, J3.1, J7.7, J7.8, J8.4, J8.5, JP2.2, R25.1, R26.1, R27.1, R28.1, R29.1, R30.1, R37.1, R38.1, R39.1, R40.1, RV1.2, U3.2, U4.3, U5.3, U6.3, U7.3, U8.3, U9.8, U10.9, U10.15
IAT_Sensor: C12.1, J1.3, R7.1, R10.2
MCU-A0: C10.1, J9.1, R6.1
MCU-A1: C9.1, J9.2, R5.1
MCU-D0: J4.8, J91.1
MCU-D1: J4.7, J90.1
MCU-D2: J4.6, J89.1
MCU-D3: J4.5, J88.1
MCU-D4: J4.4, J87.1
MCU-D5: J4.3, U9.5
MCU-D6: J4.2, U9.4
MCU-D7: J4.1, U9.3
MCU-D8: J3.7, R25.2, R31.2
MCU-D9: J3.6, R26.2, R32.2
MCU-D10: J3.5, R27.2, R33.2
MCU-D11: J3.4, R28.2, R34.2
MCU-D12: J3.3, R29.2, R35.2
MCU-D13: J3.2, R30.2, R36.2
MCU-D16: J5.1, U10.8
MCU-D17: J5.2, U10.7
MCU-D24: J6.5, U10.1
MCU-D48: J7.1, U9.6
MCU-D49: J7.2, U9.7
MCU-D50: J7.3, R37.2, R41.2
MCU-D51: J7.4, R38.2, R42.2
MCU-D52: J7.5, R39.2, R43.2
MCU-D53: J7.6, R40.2, R44.2
unnamed: C6.1, R1.2, R2.1, R4.2
unnamed: C20.1, JP1.1, R13.1
unnamed: J92.1, U9.14
unnamed: J93.1, U9.13
unnamed: J94.1, U9.12
unnamed: J95.1, U10.14
unnamed: J96.1, U10.13
unnamed: J97.1, U10.12
unnamed: J98.1, U10.11
unnamed: R5.2, U1.4
unnamed: R6.2, U2.4
unnamed: R15.2, U4.7
unnamed: R16.2, U5.7
unnamed: R17.2, U4.5
unnamed: R18.2, U5.5
unnamed: R19.2, U6.7
unnamed: R20.2, U7.7
unnamed: R21.2, U6.5
unnamed: R22.2, U7.5
unnamed: R23.2, U8.7
unnamed: R24.2, U8.5
unnamed: R31.1, U4.2
unnamed: R32.1, U4.4
unnamed: R33.1, U6.2
unnamed: R34.1, U6.4
unnamed: R35.1, U8.2
unnamed: R36.1, U8.4
unnamed: R41.1, U5.2
unnamed: R42.1, U5.4
unnamed: R43.1, U7.2
unnamed: R44.1, U7.4
unnamed: U10.5, U10.6
O2_Sensor: C5.1, J1.14, R3.2
RESET: J8.1, JP1.2, R12.1
SigRtn: C1.1, C2.1, C5.2, C6.2, C7.2, C8.2, C9.2, C10.2, C11.2, C12.2, C13.2, C14.2, C15.2, C16.2, C23.2, C24.2, D1.2, D2.2, D3.2, D4.2, D5.2, D6.2, D7.2, D8.2, D9.2, D10.2, D15.2, D16.2, J1.16, JP2.1, R1.1, U1.3, U2.3
Spare-ADC: C23.1, J1.1, R14.2
TPS_Sensor: C11.1, J1.2, R9.2
VDDA: C1.2, C2.2, F1.1, J1.4, R7.2, R8.2, U1.2, U2.2
