Hocus-Pocus/Speeduino-DP1600i-/KiCad Files/DP1600iAuxTop/DP1600iAuxTop.kicad_pcb

## KiCad design KiCad Files/DP1600iAuxTop/DP1600iAuxTop.kicad_pcb (2022-12-04)

Schematic: DP1600iAuxTop.sch

Parts:
D1, D2, D14, D15, D16, D17, D18, D19, D20, D30, D31, D32, D33: LED; LED_D5.0mm
D8, D9, D10, D11, D12, D13, D21, D26, D27, D28, D29, D34: 1N4001; D_DO-41_SOD81_P10.16mm_Horizontal
F1: 20A; 01530008Z_Fuse_Holder
F2: RXEF135-1; Fuse_Bourns_MF-RHT750
F3, F4, F5, F6, F7, F8, F9: 10A; 01530008Z_Fuse_Holder
J1: Conn_01x10; PinHeader_1x10_P2.54mm_Vertical
J5: Conn_01x02; PinHeader_1x02_P2.54mm_Vertical
J13: Conn_01x06; PinHeader_1x06_P2.54mm_Vertical
J20: Conn_01x03; PinHeader_1x03_P2.54mm_Vertical
J23: Conn_01x09; PinHeader_1x09_P2.54mm_Vertical
J30: Screw_Terminal_01x02; Phoenix_1714955
J31: Screw_Terminal_01x08; Phoenix_1729076_Rt
J32: Screw_Terminal_01x07; Phoenix_1729063_Rt
J33, J35: Screw_Terminal_01x02; Phoenix_1730010
J34: Screw_Terminal_01x06; Phoenix_1715190
J36: Screw_Terminal_01x07; Phoenix_1729063
K1: Main; VCF4-1000
K2: Automatic Shut Down; VCF4-1000
Q1, Q2, Q3, Q4, Q5, Q6: AUIRF3205; TO-220-3_Vertical_Wide
Q7, Q8, Q9, Q10: ISL9V3040P3; TO-220-3_Vertical_Wide
R1: 2.4K; R_Axial_DIN0207_L6.3mm_D2.5mm_P2.54mm_Vertical
R7, R8, R9, R10, R11, R12, R13, R19, R20, R21, R22: 2.4k; R_Axial_DIN0207_L6.3mm_D2.5mm_P10.16mm_Horizontal
R18: 2.4K; R_Axial_DIN0207_L6.3mm_D2.5mm_P10.16mm_Horizontal
RN1: R_Network03_US; R_Array_SIP4
RN2: R_Pack02_SIP; R_Array_SIP4

Connections:
12V-Raw: F2.1, J23.2, R18.1
Bat+: F1.2, J30.2
Bat+s: D21.1 (K), J31.1, K1.86
CKP+: J1.3, J32.6
CKP-: J1.4, J32.7
CLT-Sensor: J23.6, J36.4
CMP+: J5.1, J35.1
CMP-: J5.2, J35.2
D8-control: J1.8, Q3.1 (G), RN2.2 (R1.2)
D8-out: D10.1 (A), J32.1, Q3.2 (D), R10.1
D9-control: J1.7, Q4.1 (G), RN2.3 (R2.1)
D9-out: D11.1 (A), J32.3, Q4.2 (D), R11.1
D10-control: J13.3, Q5.1 (G), RN1.3 (R2)
D10-out: D12.1 (A), J34.3, Q5.2 (D), R12.1
D11-control: J13.4, Q6.1 (G), RN1.4 (R3)
D11-out: D13.1 (A), J34.4, Q6.2 (D), R13.1
D12-control: J1.6, Q1.1 (G)
D12-out: D8.1 (A), J32.2, Q1.2 (D), R8.1
D13-control: J13.2, Q2.1 (G), RN1.2 (R1)
D13-out: D9.1 (A), J34.2, Q2.2 (D), R9.1
D48-control: D34.2 (A), J13.1, K2.85
D50-control: J1.10, Q7.1 (G)
D50-out: D26.1 (A), J31.7, Q7.2 (C), R19.1
D51-control: J1.9, Q8.1 (G)
D51-out: D28.1 (A), J31.8, Q8.2 (C), R20.1
D52-control: J13.5, Q9.1 (G)
D52-out: D27.1 (A), J34.5, Q9.2 (C), R21.1
D53-control: J13.6, Q10.1 (G)
D53-out: D29.1 (A), J34.6, Q10.2 (C), R22.1
F3-out: D9.2 (K), D15.1 (A), F3.2, J33.1
F4-out: D27.2 (K), D29.2 (K), D32.1 (A), D33.1 (A), F4.2, J33.2
F5-out: D12.2 (K), D13.2 (K), D18.1 (A), D19.1 (A), F5.2, J34.1
F6-out: D10.2 (K), D11.2 (K), D16.1 (A), D17.1 (A), F6.2, J31.6
F7-out: D26.2 (K), D28.2 (K), D30.1 (A), D31.1 (A), F7.2, J31.5
F8-out: F8.2, J31.4
F9-out: D8.2 (K), D14.1 (A), F9.2, J1.5, J31.2, J31.3
GND: D1.2 (K), D2.2 (K), D20.2 (K), D21.2 (A), J1.1, J1.2, J20.1, J20.2, J20.3, J30.1, J32.5, K1.85, Q1.3 (S), Q2.3 (S), Q3.3 (S), Q4.3 (S), Q5.3 (S), Q6.3 (S), Q7.3 (E), Q8.3 (E), Q9.3 (E), Q10.3 (E), RN1.1 (common), RN2.1 (R1.1), RN2.4 (R2.2)
IAT-Sensor: J23.5, J36.3
unnamed: D1.1 (A), R7.1
unnamed: D2.1 (A), R1.2
unnamed: D14.2 (K), R8.2
unnamed: D15.2 (K), R9.2
unnamed: D16.2 (K), R10.2
unnamed: D17.2 (K), R11.2
unnamed: D18.2 (K), R12.2
unnamed: D19.2 (K), R13.2
unnamed: D20.1 (A), R18.2
unnamed: D30.2 (K), R19.2
unnamed: D31.2 (K), R20.2
unnamed: D32.2 (K), R21.2
unnamed: D33.2 (K), R22.2
unnamed: D34.1 (K), F2.2, K1.87, K2.30, K2.86
unnamed: F1.1, K1.30
unnamed: F3.1, F4.1, F5.1, F6.1, F7.1, F8.1, F9.1, K2.87, R1.1
O2-Sensor: J23.8, J36.6
SigRtn: J23.4, J36.2
Spare-ADC: J23.9, J36.7
TPS-Sensor: J23.7, J36.5
Tachometer: J23.1, J32.4, R7.2
VDDA: J23.3, J36.1

Notes on the sheet:
YlGn
Inj1 & Inj2 +
Inj3 & Inj4 +
Ign1 & Ign2 +
Ign3 & Ign4 +
WB & Tach & PWM Idle +
(Ign1)
(Inj1)
(Ign2)
(Ign3)
(Ign4)
(Inj2)
(Inj3)
(Inj4)
(PWM Idle)
(Spare out)
Flyback
Battery negative
Battery positive
Battery switched start & run
Tachometer signal
Tach & WB & Idle +
Fuel Pump +
Inj1
Inj2
Ign1
Ign2
Inj3
Inj4
Ign3
Ign4
IAT
CLT
ADC Gnd
TPS
ADC 5V
WB O2
Spare ADC
CKP VR+
CKP VR-
CMP VR-
CMP VR+
Spare High Current Output +
Spare High Current Output -
12 volt from main relay
PWM Idle
ASD relay control
Sensor ground
Throttle Position Sensor
Wide Band O2 sensor
Cylinder head temperaure
Inlet Air Temperature
(12 volt square wave signal to tachometer)
Spare high current output
Ign4
Right side vehicle wiring terminals
Left side vehicle wiring terminals
Header terminal connections to DB1600iAuxBot board
100K

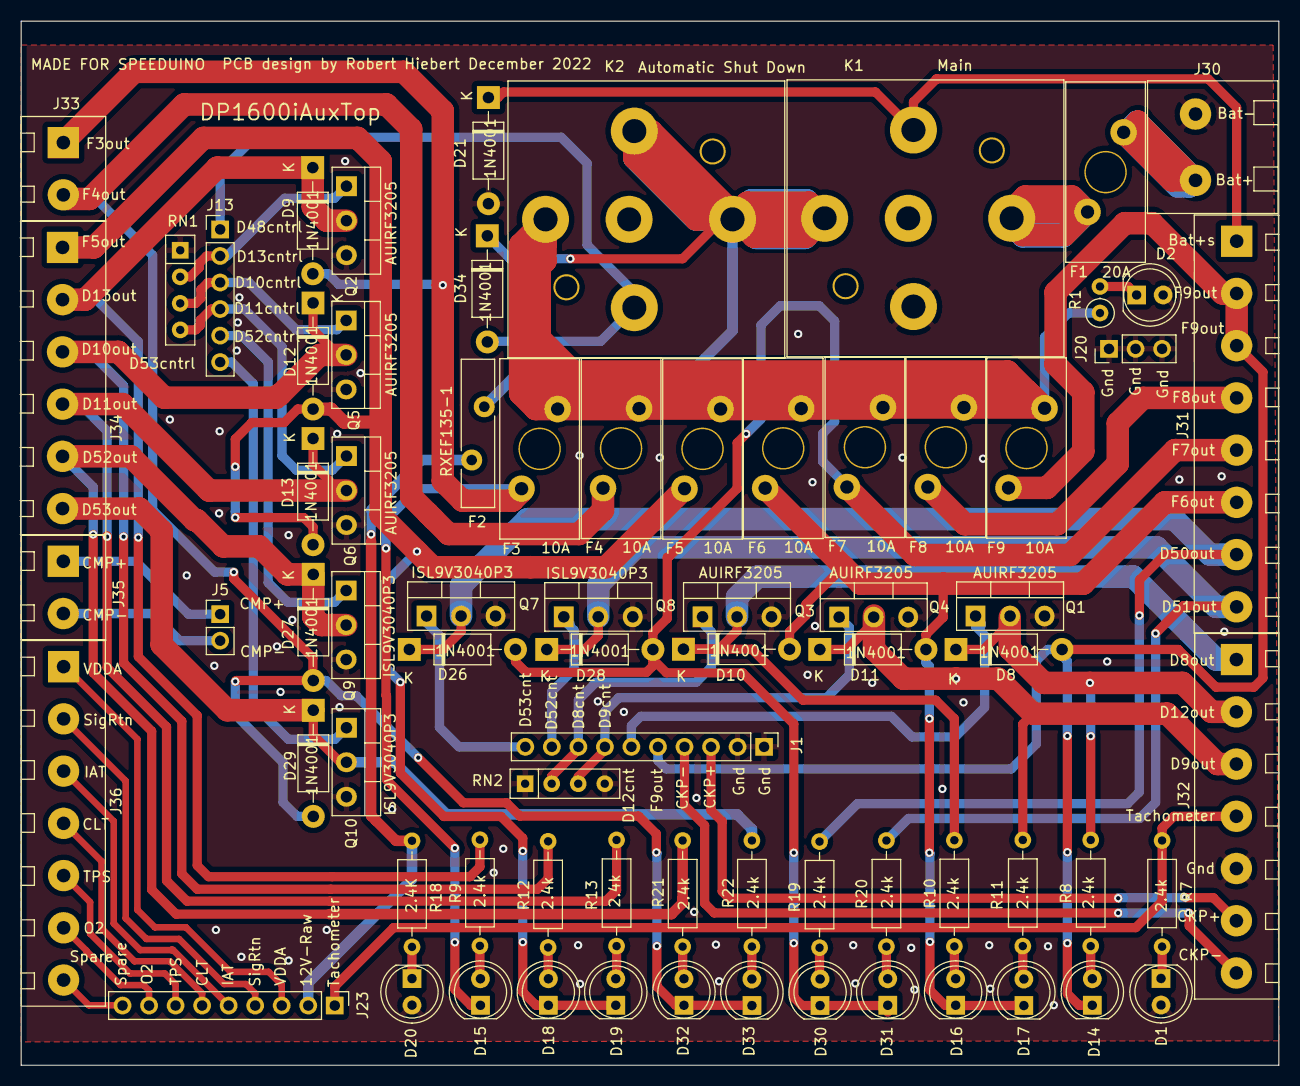
[picture p12: board DP1600iAuxTop.kicad_pcb from above]

Board: 2 copper layers, 120.4 x 99.9 mm, 73 parts (0 on the bottom side), 60 nets.
