Hocus-Pocus/Speeduino-DP1600i-/KiCad Files/VR Conditioner/VR-Conditioner-MAX9926+reg.kicad_pcb

## KiCad design KiCad Files/VR Conditioner/VR-Conditioner-MAX9926+reg.kicad_pcb (2022-11-15)

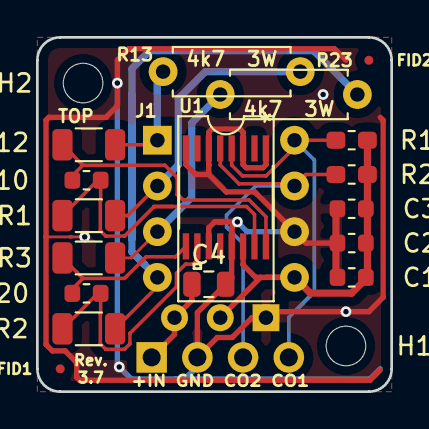
[picture p13: board VR-Conditioner-MAX9926+reg.kicad_pcb from above]

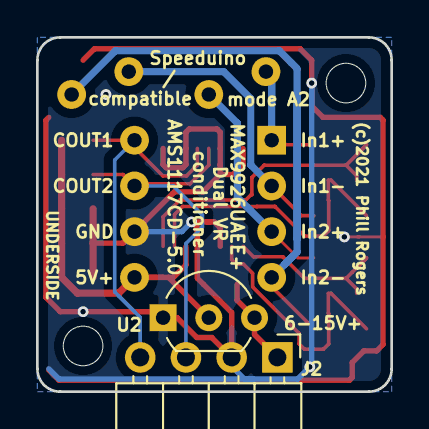
[picture p14: board VR-Conditioner-MAX9926+reg.kicad_pcb from below]

Board: 2 copper layers, 19.7 x 19.7 mm, 22 parts (2 on the bottom side), 13 nets.

Parts:
C1: 10n; C_0603_1608Metric
C2: 100n; C_0603_1608Metric
C3: 1u; C_0603_1608Metric
C4: 10u; C_0805_2012Metric
C10, C20: 1n; C_0603_1608Metric
FID1, FID2: Fiducial; Fiducial_0.5mm_Mask1mm
H1, H2: MountingHole; MountingHole_2.2mm_M2
J1: 8-pin header; DIP-8_W7.62mm
J2: Edge; PinHeader_1x04_P2.54mm_Horizontal
R1, R2, R3, R12: 10k; R_1206_3216Metric
R10, R20: 1k; R_0603_1608Metric_Pad1.05x0.95mm_HandSolder
R13, R23: 4.7k; R_Axial_DIN0207_L6.3mm_D2.5mm_P7.62mm_Horizontal
U1: MAX9926UAEE+; MAX9926UAEE&plus_
U2: AMS1117CD-5.0; TO-92_Inline_Wide

Connections:
+12V: C4.1, J2.1, U2.3
/COUT1: J1.8, J2.4, R10.2, U1.4
/COUT2: J1.7, J2.3, R20.2, U1.5
GND: C1.2, C2.2, C3.2, C4.2, J1.6, J2.2, U1.1, U1.3, U1.6, U1.8, U1.11, U1.13, U2.1
unnamed: C10.1, R12.1, U1.16
unnamed: C10.2, R1.1, U1.15
unnamed: C20.1, R2.1, U1.10
unnamed: C20.2, R3.1, U1.9
unnamed: J1.1, R12.2, R13.1
unnamed: J1.2, R1.2, R13.2
unnamed: J1.3, R3.2, R23.1
unnamed: J1.4, R2.2, R23.2
VCC: C1.1, C2.1, C3.1, J1.5, R10.1, R20.1, U1.14, U2.2
