Hocus-Pocus/Speeduino-DP1600i-/KiCad Files/Speeduino Pin Test/Speeduino Pin Test Board.kicad_pcb

## KiCad design KiCad Files/Speeduino Pin Test/Speeduino Pin Test Board.kicad_pcb (2022-11-15)

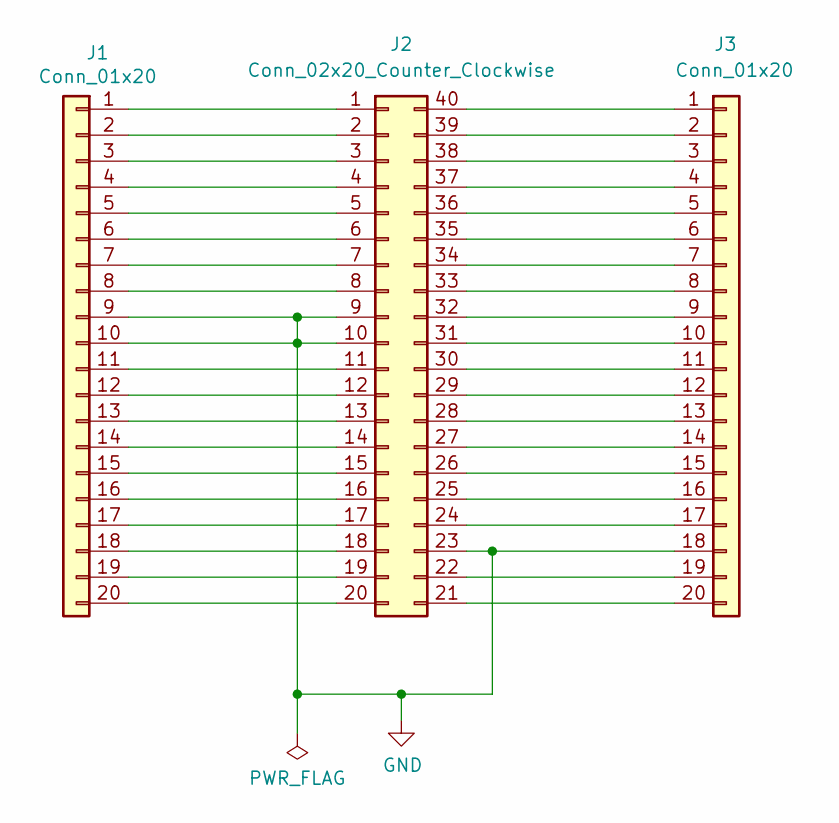
[picture p15: schematic Speeduino Pin Test Board.sch]

Parts:
J1, J3: Conn_01x20; PinHeader_1x20_P2.54mm_Vertical
J2: Conn_02x20_Counter_Clockwise; PinHeader_2x20_P2.54mm_Vertical_CW

Connections:
GND: J1.9, J1.10, J2.9, J2.10, J2.23, J3.18
unnamed: J1.1, J2.1
unnamed: J1.2, J2.2
unnamed: J1.3, J2.3
unnamed: J1.4, J2.4
unnamed: J1.5, J2.5
unnamed: J1.6, J2.6
unnamed: J1.7, J2.7
unnamed: J1.8, J2.8
unnamed: J1.11, J2.11
unnamed: J1.12, J2.12
unnamed: J1.13, J2.13
unnamed: J1.14, J2.14
unnamed: J1.15, J2.15
unnamed: J1.16, J2.16
unnamed: J1.17, J2.17
unnamed: J1.18, J2.18
unnamed: J1.19, J2.19
unnamed: J1.20, J2.20
unnamed: J2.21, J3.20
unnamed: J2.22, J3.19
unnamed: J2.24, J3.17
unnamed: J2.25, J3.16
unnamed: J2.26, J3.15
unnamed: J2.27, J3.14
unnamed: J2.28, J3.13
unnamed: J2.29, J3.12
unnamed: J2.30, J3.11
unnamed: J2.31, J3.10
unnamed: J2.32, J3.9
unnamed: J2.33, J3.8
unnamed: J2.34, J3.7
unnamed: J2.35, J3.6
unnamed: J2.36, J3.5
unnamed: J2.37, J3.4
unnamed: J2.38, J3.3
unnamed: J2.39, J3.2
unnamed: J2.40, J3.1

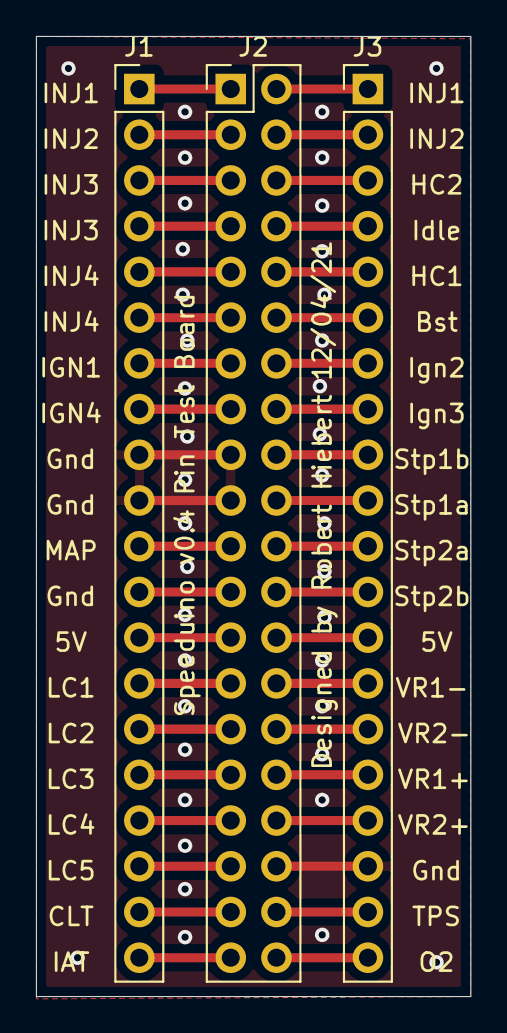
[picture p16: board Speeduino Pin Test Board.kicad_pcb from above]

Board: 2 copper layers, 24.1 x 53.3 mm, 3 parts (0 on the bottom side), 38 nets.
