Hocus-Pocus/Speeduino-DP1600i-/KiCad Files/Single VR Conditioner/Single VR Conditioner.kicad_pcb

## KiCad design KiCad Files/Single VR Conditioner/Single VR Conditioner.kicad_pcb (2022-11-15)

Schematic: Single VR Conditioner.sch, Buggly Gruesome Single VR Conditioner

Parts:
C1: 330pf; C_Rect_L7.2mm_W4.5mm_P5.00mm_FKS2_FKP2_MKS2_MKP2
C2: .33uf; C_Rect_L7.2mm_W4.5mm_P5.00mm_FKS2_FKP2_MKS2_MKP2
C3: .1uf; C_Rect_L7.2mm_W4.5mm_P5.00mm_FKS2_FKP2_MKS2_MKP2
C4: .01uf; C_Rect_L10.3mm_W4.5mm_P7.50mm_MKS4
R1: 300R; R_Axial_DIN0207_L6.3mm_D2.5mm_P10.16mm_Horizontal
R2: 18K; R_Axial_DIN0207_L6.3mm_D2.5mm_P10.16mm_Horizontal
R3: 1.1M; R_Axial_DIN0207_L6.3mm_D2.5mm_P10.16mm_Horizontal
R4: 4.7K; R_Axial_DIN0207_L6.3mm_D2.5mm_P10.16mm_Horizontal
R5: 39K; R_Axial_DIN0207_L6.3mm_D2.5mm_P10.16mm_Horizontal
R6: 1K; R_Axial_DIN0207_L6.3mm_D2.5mm_P10.16mm_Horizontal
U1: LM1815; SOIC-14_W3.9mm
U2: DIP8; DIP-8_W10.16mm

Connections:
5Volt: C3.1, R4.1, R5.1, U1.8, U2.5
unnamed: C1.1, R2.1, U1.3
unnamed: C2.1, R3.1, U1.7
unnamed: C4.1, R5.2, U1.14
unnamed: R4.2, R6.2, U1.12
VR+: R1.1, R2.2, U2.3
VR-: C1.2, C2.2, C3.2, C4.2, R1.2, R3.2, U1.2, U1.9, U1.11, U2.1, U2.2
Vout: R6.1, U2.7

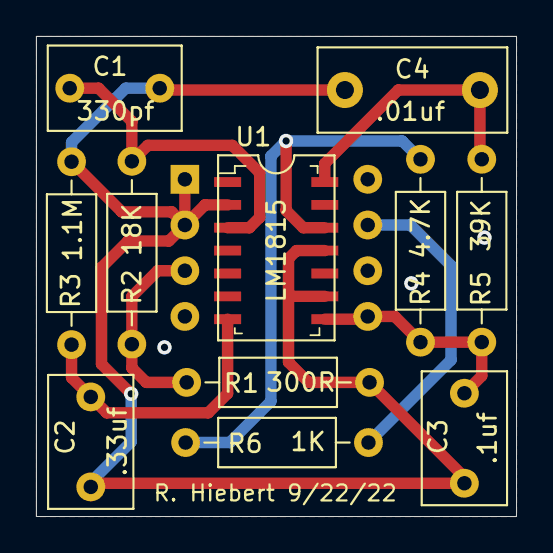
[picture p17: board Single VR Conditioner.kicad_pcb from above]

Board: 2 copper layers, 26.7 x 26.7 mm, 12 parts (0 on the bottom side), 8 nets.
