Hocus-Pocus/Speeduino-DP1600i-/KiCad Files/Dual Opto Board/Speeduino Dual Opto Board.kicad_pcb

## KiCad design KiCad Files/Dual Opto Board/Speeduino Dual Opto Board.kicad_pcb (2022-11-15)

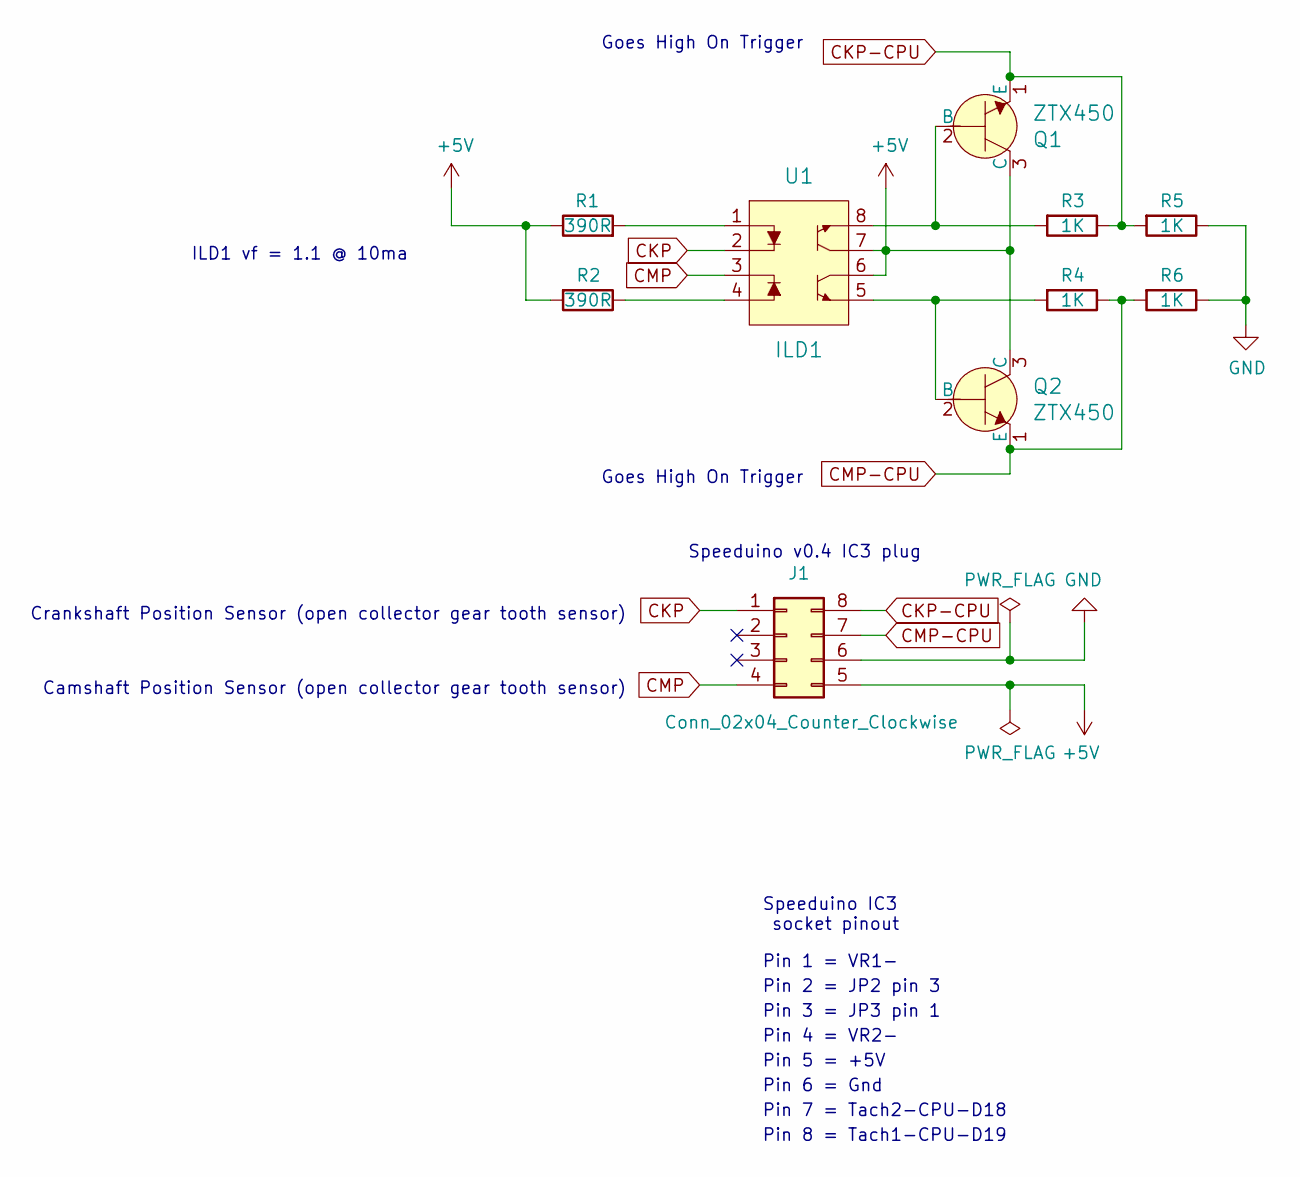
[picture p18: schematic Speeduino Dual Opto Board.sch]

Parts:
J1: Conn_02x04_Counter_Clockwise; DIP-8_W7.62mm
Q1, Q2: ZTX450; TO-92_Inline_Wide; MPN ZTX450; Digi-Key_PN ZTX450-ND
R1, R2: 390R; R_Axial_DIN0207_L6.3mm_D2.5mm_P10.16mm_Horizontal
R3, R4, R5, R6: 1K; R_Axial_DIN0207_L6.3mm_D2.5mm_P10.16mm_Horizontal
U1: ILD1; DIP-8_W7.62mm; MPN ILD207T; Digi-Key_PN 751-1310-1-ND

Connections:
+5V: J1.5, Q1.3 (C), Q2.3 (C), R1.1, R2.2, U1.6, U1.7
CKP: J1.1, U1.2
CKP-CPU: J1.8, Q1.1 (E), R3.1, R5.2
CMP: J1.4, U1.3
CMP-CPU: J1.7, Q2.1 (E), R4.1, R6.2
GND: J1.6, R5.1, R6.1
unnamed: Q1.2 (B), R3.2, U1.8
unnamed: Q2.2 (B), R4.2, U1.5
unnamed: R1.2, U1.1
unnamed: R2.1, U1.4

Notes on the sheet:
Crankshaft Position Sensor (open collector gear tooth sensor)
Goes High On Trigger
Camshaft Position Sensor (open collector gear tooth sensor)
Speeduino v0.4 IC3 plug
Speeduino IC3 socket pinout
Pin 1 = VR1-
Pin 2 = JP2 pin 3
Pin 3 = JP3 pin 1
Pin 4 = VR2-
Pin 5 = +5V
Pin 6 = Gnd
Pin 7 = Tach2-CPU-D18
Pin 8 = Tach1-CPU-D19
ILD1 vf = 1.1 @ 10ma

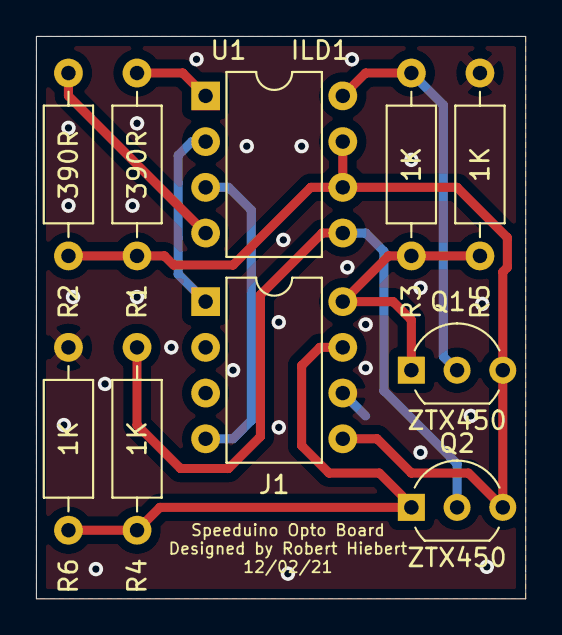
[picture p19: board Speeduino Dual Opto Board.kicad_pcb from above]

Board: 2 copper layers, 27.2 x 31.2 mm, 10 parts (0 on the bottom side), 10 nets.
