Hocus-Pocus/Speeduino-DP1600i-/(notices)

Notices in the files:
KiCad Files/VR Conditioner/VR-Conditioner-MAX9926+reg.kicad_pcb:
(c)2021 Phill Rogers @ TechColab.co.je
parts and their libraries:
Copyright 2016 Accelerated Designs. All rights reserved.
